nfakkel/DeciZebroPowerSystemControl/README.md

# DeciZebroPowerSystemControl
This repository contains the microcontroller firmware code, the data analysis code and schematics. All are discussed in the Bachelor Thesis: Development of Power System Control for the DeciZebro
