nfakkel/DeciZebroPowerSystemControl/Firmware/Firmware_overview_bms.xlsx

Sheet: SMBUS_ADDRESSES
List of register adresses of sensors |  |  |  | ! in datasheet conf 01h en temp 00h??
 |  | i2c address | Registername | Address | Bits | Description
LM75BD | input: | 1001000 | Conf | 00h | B[4:3] OS_F_QUE[1:0] | Set aantal keer dat Overtemp gemeten moet worden voor alert af gaat
https://www.nxp.com/docs/en/data-sheet/LM75B.pdf | output: | 1001001 |  |  |  | 0 | 1x
 |  |  |  |  |  | 1 | 2x
 |  |  |  |  |  | 2 | 4x
 |  |  |  |  |  | 3 | 6x
 |  |  |  |  | B2 | OS polarity default = 0 we willen active high dus 1
 |  |  |  |  | B1 | OS operation mode default = 0
 |  |  |  |  | B0 | shutdown = 1
 |  |  | Temp | 01h | temperature 2 bytes | two's complement 11 bits 0.125C resolution
 |  |  |  |  | D10 = 0 -> positive temp
 |  |  |  |  | D9 - D0 x 0.125C = temp
 |  |  | Tos | 03h | overtemp shutdown 2 bytes (default 80C)
 |  |  |  |  | D8 - D0 | 0.5C resolution | D8 MSB
 |  |  | Thyst | 05h | D8-D0 | leuk idk
INA226 | PV: | 1000010 | Configuration | 00h
http://www.ti.com/lit/ds/symlink/ina226.pdf | Bus: | 1000000 | Shunt | 01h
 | 5V: | 1000001 | Bus voltage | 02h
 | 3.3V: | 1000011 | power | 03h
 |  |  | Current | 04h
 |  |  | Calibration | 05h
AD5121 |  | 010 1111 | RDAC | ??? | d6-d0?? | Rpot = D/128 * Rab + Rw
http://www.analog.com/media/en/technical-documentation/data-sheets/AD5121_5141.pdf
P9921-R |  | 1100001 | p25-29
https://nl.mouser.com/datasheet/2/464/IDT_P9221-R-Datasheet_DST_20171010-1093280.pdf

Sheet: VIRTUAL_REGISTER_DEFENITIONS
Address |  | Direction | Name | Description | Initial value
Dec | Hex | r
0 | 0x00 | r | ZebroBus version | Highest of the ZebroBus protocol supported
1 | 0x01 | r | class id | Class this module is part of
2 | 0x02 | r | product id | Product ID of this module
3 | 0x03 | r | product version | Product version of this module
4 | 0x04 | r | serial id | Serial number of this module
5 | 0x05 | r | software version | Software version of this module
6 | 0x06 | r | zebrobus address | Primary ZebroBus slave address of this module
7 | 0x07 | r | reserved | Reserved for future use
… | … | r | reserved | Reserved for future use
16 | 0x0F | r | reserved | Reserved for future use
17 | 0x10 | r | quick status | One byte module status message
18 | 0x11 | r | sync counter | Time synchronisation counter
19 | 0x12 | r | loop counter | Counts the times we go through the main control loop
20 | 0x13 | r | error counter | Counts the number of errors that occurred
21 | 0x14 | r | last error | Error code of the last error
22 | 0x15 | r | reserved | Reserved for future use
… | … | r | reserved | Reserved for future use
31 | 0x1F | r | reserved | Reserved for future use
32 | 0x20 | r | State Power System | State of the power system(0x00=shutdown, 0x01=charge, 0x02=discharge, 0x04=error)
33 | 0x21 | r | State Solar input | State of the solar cell(0x00=off, 0x01=on, 0x02=too low, 0x03=too high, 0x04=error)
34 | 0x22 | r | State QI input | State of the qi input(0x00=off, 0x01=on, 0x02=too low, 0x03=too high, 0x04=error)
35 | 0x23 | r | State Laptop input | State of the laptop charge input(0x00=off, 0x01=on, 0x02=too low, 0x03=too high, 0x04=error)
36 | 0x24 | r | State 3.3V output | State of the 3.3V output(0x00=off, 0x01=on, 0x02=too low, 0x03=too high, 0x04=error)
37 | 0x25 | r | State 5V output | State of the 5V output(0x00=off, 0x01=on, 0x02=too low, 0x03=too high, 0x04=error)
38 | 0x26 | r | State 16V output | State of the 16V output(0x00=off, 0x01=on, 0x02=too low, 0x03=too high, 0x04=error)
 |  |  | soc | State of charge of the batteries
 |  |  | soh | State of health of the batteries
 |  |  | battery voltage | Voltage across the battery array [V]
 |  |  | capacity | Capacity of the batteries [mAh]
 |  |  | maximum cell voltage | Maximum voltage across a single battery cell [V]
 |  |  | cell count | Number of cells in battery
 |  |  | maximum current | Maximum current that the batteries can deliver [A]
39 | 27 | r | reserved | Reserved for future use
... | ... | r | reserved | Reserved for future use
64 | 3F | r | reserved | Reserved for future use
