nfakkel/DeciZebroPowerSystemControl/Schematics/BOM/ExcelSheetBOM.xls

Sheet: LM5177
Part | Manufacturer | Part Number | Quantity | Price | Attribute 1 Name | Attribute 1 Value | Attribute 2 Name | Attribute 2 Value | Attribute 3 Name | Attribute 3 Value | Footprint
Cboot1 | Kemet | C0603C104Z3VACTU | 1 | 0.01 | Cap | 100nF | ESR | 1mOhm | Total Derated Cap | 1.0E-7F | 603
Cboot2 | Kemet | C0603C104Z3VACTU | 1 | 0.01 | Cap | 100nF | ESR | 1mOhm | Total Derated Cap | 1.0E-7F | 603
Cbulk | Nichicon | UUD1E680MCL1GS | 1 | 0.12 | Cap | 68uF | ESR | 0.44Ohm | Total Derated Cap | 6.8E-5F | SM_RADIAL_6.3AMM
Ccomp | TDK | C2012C0G1H153J085AA | 1 | 0.07 | Cap | 15nF | ESR | 0Ohm | Total Derated Cap | 1.5E-8F | 805
Ccomp2 | Samsung Electro-Mechanics | CL21C910JBANNNC | 1 | 0.01 | Cap | 91pF | ESR | 0Ohm | Total Derated Cap | 9.1E-11F | 805
Ccs | AVX | 06035A470JAT2A | 1 | 0.01 | Cap | 47pF | ESR | 0.174Ohm | Total Derated Cap | 4.7E-11F | 603
Cf | TDK | C1608X5R1H104K080AA | 1 | 0.01 | Cap | 100nF | ESR | 0.03Ohm | Total Derated Cap | 1.0E-7F | 603
Cin | MuRata | GRM32DR61E106KA12L | 3 | 0.15 | Cap | 10uF | ESR | 2.237mOhm | Total Derated Cap | 1.7E-5F | 1210_280
Cout | Panasonic | 20SVP150M | 1 | 0.76 | Cap | 150uF | ESR | 0.02Ohm | Total Derated Cap | 1.5E-4F | SM_RADIAL_10AMM
Coutx | TDK | C2012X5R1V226M125AC | 1 | 0.38 | Cap | 22uF | ESR | 2.05mOhm | Total Derated Cap | 1.2E-5F | 805
Coutx2 | TDK | C2012X5R1V226M125AC | 1 | 0.38 | Cap | 22uF | ESR | 2.05mOhm | Total Derated Cap | 1.2E-5F | 805
Coutx3 | TDK | C2012X5R1V226M125AC | 1 | 0.38 | Cap | 22uF | ESR | 2.05mOhm | Total Derated Cap | 1.2E-5F | 805
Cslope | Samsung Electro-Mechanics | CL10C111JB8NNNC | 1 | 0.01 | Cap | 110pF | ESR | 0Ohm | Total Derated Cap | 1.1E-10F | 603
Css | Kemet | C0603C153J3GACTU | 1 | 0.09 | Cap | 15nF | ESR | 0Ohm | Total Derated Cap | 1.5E-8F | 603
Cvcc | MuRata | GRM188R61C105KA93D | 1 | 0.02 | Cap | 1uF | ESR | 0.01Ohm | Total Derated Cap | 1.0E-6F | 603
Dboot1 | Nexperia | PMEG6010CEH,115 | 1 | 0.0422 | VFatIo | 0.57V | Io | 1A | VRRM | 60V | SOD-123F
Dboot2 | Nexperia | PMEG6010CEH,115 | 1 | 0.0422 | VFatIo | 0.57V | Io | 1A | VRRM | 60V | SOD-123F
Df | Fairchild Semiconductor | SS14FL | 1 | 0.06 | VFatIo | 0.55V | Io | 1A | VRRM | 40V | SOD-123F
L1 | Coilcraft | XAL7070-222MEB | 1 | 1.19 | L | 2.2uH | DCR | 5.7mOhm | IDC | 17.8A | XAL7070
M1 | Texas Instruments | CSD17310Q5A | 1 | 0.31 | VdsMax | 30V | IdsMax | 100A | Rdson | 5.9mOhm | TRANS_NexFET_Q5A
M2 | Texas Instruments | CSD18514Q5A | 1 | 0.27 | VdsMax | 40V | IdsMax | 50A | Rdson | 7.9mOhm | TRANS_NexFET_Q5A
M3 | Texas Instruments | CSD16321Q5 | 1 | 0.61 | VdsMax | 25V | IdsMax | 100A | Rdson | 2.6mOhm | TRANS_NexFET_Q5
M4 | Texas Instruments | CSD18511Q5A | 1 | 0.44 | VdsMax | 40V | IdsMax | 100A | Rdson | 3.5mOhm | TRANS_NexFET_Q5A
Rcomp | Vishay-Dale | CRCW040210K2FKED | 1 | 0.01 | Resistance | 10.2kOhm | Tolerance | 1% | Power | 0.063W | 402
Rcsg | Vishay-Dale | CRCW0603100RFKEA | 1 | 0.01 | Resistance | 100Ohm | Tolerance | 1% | Power | 0.1W | 603
Rcsp | Vishay-Dale | CRCW0603100RFKEA | 1 | 0.01 | Resistance | 100Ohm | Tolerance | 1% | Power | 0.1W | 603
Rf | Vishay-Dale | CRCW060310R0FKEA | 1 | 0.01 | Resistance | 10Ohm | Tolerance | 1% | Power | 0.1W | 603
Rfbb | Yageo America | RC0603FR-0720KL | 1 | 0.01 | Resistance | 20kOhm | Tolerance | 1% | Power | 0.1W | 603
Rfbt | Yageo America | RC0603FR-07383KL | 1 | 0.01 | Resistance | 383kOhm | Tolerance | 1% | Power | 0.1W | 603
Rpg | Vishay-Dale | CRCW060310K0FKEA | 1 | 0.01 | Resistance | 10kOhm | Tolerance | 1% | Power | 0.1W | 603
Rsense | Rohm | PMR100HZPFU6L00 | 1 | 0.17 | Resistance | 6mOhm | Tolerance | 1% | Power | 2W | 2512
Rt | Vishay-Dale | CRCW040223K2FKED | 1 | 0.01 | Resistance | 23.2kOhm | Tolerance | 1% | Power | 0.063W | 402
Ruvb | Vishay-Dale | CRCW040229K4FKED | 1 | 0.01 | Resistance | 29.4kOhm | Tolerance | 1% | Power | 0.063W | 402
Ruvt | Vishay-Dale | CRCW0402249KFKED | 1 | 0.01 | Resistance | 249kOhm | Tolerance | 1% | Power | 0.063W | 402
U1 | Texas Instruments | LM5176PWPR | 1 | 3 |  |  |  |  |  |  | PWP0028C_N
Cbias | MuRata | GRM21BR71H104KA01L | 1 | 0.04 | Cap | 100nF | ESR | 1mOhm | Total Derated Cap | 1.0E-7F | 805
Rmode | Vishay-Dale | CRCW060393K1FKEA | 1 | 0.01 | Resistance | 93.1kOhm | Tolerance | 1% | Power | 0.1W | 603

Sheet: Control + BMS
Reference | Value | Footprint | Datasheet
J9 | Conn_02x03_Counter_Clockwise
D3 | LED |  | http://www.produktinfo.conrad.com/datenblaetter/175000-199999/184543-da-01-en-LED_20_5mm_rot_WU_8_53_HD.pdf
R4 | R | Resistors_SMD:R_1206 | https://nl.mouser.com/datasheet/2/427/rcge3-254226.pdf
D4 | LED |  | http://www.produktinfo.conrad.com/datenblaetter/175000-199999/184543-da-01-en-LED_20_5mm_rot_WU_8_53_HD.pdf
R5 | R | Resistors_SMD:R_1206 | https://nl.mouser.com/datasheet/2/427/rcge3-254226.pdf
D2 | LED |  | http://www.produktinfo.conrad.com/datenblaetter/175000-199999/184543-da-01-en-LED_20_5mm_rot_WU_8_53_HD.pdf
R3 | R | Resistors_SMD:R_1206 | https://nl.mouser.com/datasheet/2/427/rcge3-254226.pdf
D6 | LED |  | http://www.produktinfo.conrad.com/datenblaetter/175000-199999/184543-da-01-en-LED_20_5mm_rot_WU_8_53_HD.pdf
R7 | R | Resistors_SMD:R_1206 | https://nl.mouser.com/datasheet/2/427/rcge3-254226.pdf
D7 | LED |  | http://www.produktinfo.conrad.com/datenblaetter/175000-199999/184543-da-01-en-LED_20_5mm_rot_WU_8_53_HD.pdf
R8 | R | Resistors_SMD:R_1206 | https://nl.mouser.com/datasheet/2/427/rcge3-254226.pdf
D5 | LED |  | http://www.produktinfo.conrad.com/datenblaetter/175000-199999/184543-da-01-en-LED_20_5mm_rot_WU_8_53_HD.pdf
R6 | R | Resistors_SMD:R_1206 | https://nl.mouser.com/datasheet/2/427/rcge3-254226.pdf
D8 | LED |  | http://www.produktinfo.conrad.com/datenblaetter/175000-199999/184543-da-01-en-LED_20_5mm_rot_WU_8_53_HD.pdf
R9 | R | Resistors_SMD:R_1206 | https://nl.mouser.com/datasheet/2/427/rcge3-254226.pdf
D1 | LED |  | http://www.produktinfo.conrad.com/datenblaetter/175000-199999/184543-da-01-en-LED_20_5mm_rot_WU_8_53_HD.pdf
R2 | R | Resistors_SMD:R_1206 | https://nl.mouser.com/datasheet/2/427/rcge3-254226.pdf
J6 | Conn_02x03_Counter_Clockwise
R1 | 10k
J3 | Conn_01x02
J1 | Conn_01x02
J2 | Conn_01x03
J12 | Conn_01x02
J11 | BMS_DATA_OUT |  | FWS-02-01-T-S
J5 | Conn_01x05 |  | JST-XH 4s
J4 | Conn_01x02
J10 | BMS_POWER_OUT
J8 | BMS_POWER_IN
J7 | BMS_DATA_IN |  | FWS-02-01-T-S
J13 | Conn_01x04 |  | Molex KK 2045
J14 | Conn_01x04 |  | Molex KK 2045
J15 | Conn_01x04 |  | Molex KK 2045
32KHz1 | Crystal
C3 | 18pF
C4 | 18pF
U4 | P82B96
R20 | 2.7k
R19 | 2.7k
R16 | 10k
R17 | 10k
R18 | 100k
Q1 | Q_NMOS_DGS
L1 | Ferrite_Bead | Resistors_SMD:R_0201 | http://www.farnell.com/datasheets/1740433.pdf
C8 | 10u
SW1 | SW_Push
U3 | ATXMEGA32A4U-MH | VQFN44
U1 | LM75
C1 | 0.1u
R11 | 10k | Resistors_SMD:R_0201 | http://www.farnell.com/datasheets/2549522.pdf
C10 | 0.1u
C11 | 0.1u
C5 | CP1
D9 | D_Schottky
C9 | .1u
U2 | LM75
C2 | 0.1u
R12 | 10k | Resistors_SMD:R_0201 | http://www.farnell.com/datasheets/2549522.pdf
R14 | 10k | Resistors_SMD:R_0201 | http://www.farnell.com/datasheets/2549522.pdf
D11 | D_Zener
D12 | D_Zener
D13 | D_Zener
D14 | D_Zener
R10 | 10k | Resistors_SMD:R_0201 | http://www.farnell.com/datasheets/2549522.pdf
R13 | 10k | Resistors_SMD:R_0201 | http://www.farnell.com/datasheets/2549522.pdf
R15 | 10k | Resistors_SMD:R_0201 | http://www.farnell.com/datasheets/2549522.pdf
C6 | 10u
C7 | .1u
D10 | D_Zener
R21 | 1k | Resistors_SMD:R_1206 | https://nl.mouser.com/datasheet/2/427/rcge3-254226.pdf
R22 | 1k | Resistors_SMD:R_1206 | https://nl.mouser.com/datasheet/2/427/rcge3-254226.pdf
R23 | 1k | Resistors_SMD:R_1206 | https://nl.mouser.com/datasheet/2/427/rcge3-254226.pdf
R24 | 1k | Resistors_SMD:R_1206 | https://nl.mouser.com/datasheet/2/427/rcge3-254226.pdf
R25 | 1k | Resistors_SMD:R_1206 | https://nl.mouser.com/datasheet/2/427/rcge3-254226.pdf
R28 | 10k | Resistors_SMD:R_1206 | https://nl.mouser.com/datasheet/2/427/rcge3-254226.pdf
R31 | 1M | Resistors_SMD:R_1206
R33 | 1M | Resistors_SMD:R_1206 | https://nl.mouser.com/datasheet/2/427/rcge3-254226.pdf
R34 | 1M | Resistors_SMD:R_1206 | https://nl.mouser.com/datasheet/2/427/rcge3-254226.pdf
R32 | 100 | Resistors_SMD:R_1206 | https://nl.mouser.com/datasheet/2/427/rcge3-254226.pdf
Q2 | BSZ105N04NSGATMA1 | TO_SOT_Packages_THT:TO-92_Molded_Narrow | https://www.infineon.com/dgdl/Infineon-BSZ105N04NSG-DS-v02_00-en.pdf?fileId=db3a30431689f4420116c485c67f084e
Q4 | BSZ105N04NSGATMA1 | TO_SOT_Packages_THT:TO-92_Molded_Narrow | https://www.infineon.com/dgdl/Infineon-BSZ105N04NSG-DS-v02_00-en.pdf?fileId=db3a30431689f4420116c485c67f084e
Q3 | NVR1P02T1G | TO_SOT_Packages_THT:TO-220_Vertical | https://docs-emea.rs-online.com/webdocs/12e2/0900766b812e287b.pdf
C16 | 1uF | Capacitors_THT:CP_Radial_D22.0mm_P10.00mm_SnapIn | https://docs-emea.rs-online.com/webdocs/13ec/0900766b813ec20a.pdf
C14 | 1uF | Capacitors_THT:CP_Radial_D22.0mm_P10.00mm_SnapIn | https://docs-emea.rs-online.com/webdocs/13ec/0900766b813ec20a.pdf
C13 | 1uF | Capacitors_THT:CP_Radial_D22.0mm_P10.00mm_SnapIn | https://docs-emea.rs-online.com/webdocs/13ec/0900766b813ec20a.pdf
C12 | 1uF | Capacitors_THT:CP_Radial_D22.0mm_P10.00mm_SnapIn | https://docs-emea.rs-online.com/webdocs/13ec/0900766b813ec20a.pdf
C20 | 1uF | Capacitors_THT:CP_Radial_D22.0mm_P10.00mm_SnapIn | https://docs-emea.rs-online.com/webdocs/13ec/0900766b813ec20a.pdf
C21 | 1uF | Capacitors_THT:CP_Radial_D22.0mm_P10.00mm_SnapIn | https://docs-emea.rs-online.com/webdocs/13ec/0900766b813ec20a.pdf
C22 | 1uF | Capacitors_THT:CP_Radial_D22.0mm_P10.00mm_SnapIn | https://docs-emea.rs-online.com/webdocs/13ec/0900766b813ec20a.pdf
C23 | 1uF | Capacitors_THT:CP_Radial_D22.0mm_P10.00mm_SnapIn | https://docs-emea.rs-online.com/webdocs/13ec/0900766b813ec20a.pdf
MMDL301T1G1 | D |  | https://www.onsemi.com/pub/Collateral/MMDL301T1-D.PDF
D_zener1 | ds18010 |  | https://www.diodes.com/assets/Datasheets/ds18010.pdf
R29 | 10k Thermistor |  | https://nl.mouser.com/datasheet/2/362/semitec_atthermistor-1202913.pdf
X1 | bq78350-R1 |  | http://www.ti.com/lit/ds/symlink/bq78350-r1.pdf
R36 | R | Resistors_SMD:R_1206 | https://nl.mouser.com/datasheet/2/427/rcge3-254226.pdf
R37 | R | Resistors_SMD:R_1206 | https://nl.mouser.com/datasheet/2/427/rcge3-254226.pdf
R38 | R | Resistors_SMD:R_1206 | https://nl.mouser.com/datasheet/2/427/rcge3-254226.pdf
R39 | R | Resistors_SMD:R_1206 | https://nl.mouser.com/datasheet/2/427/rcge3-254226.pdf
Q5 | Q_PJFET_SDG
Q6 | Q_NJFET_SDG
R40 | 100k | Resistors_SMD:R_1206 | https://nl.mouser.com/datasheet/2/427/rcge3-254226.pdf
C24 | 0.1uF | Capacitors_THT:CP_Radial_D22.0mm_P10.00mm_SnapIn | https://docs-emea.rs-online.com/webdocs/13ec/0900766b813ec20a.pdf
D15 | LED |  | http://www.produktinfo.conrad.com/datenblaetter/175000-199999/184543-da-01-en-LED_20_5mm_rot_WU_8_53_HD.pdf
D16 | LED |  | http://www.produktinfo.conrad.com/datenblaetter/175000-199999/184543-da-01-en-LED_20_5mm_rot_WU_8_53_HD.pdf
D17 | LED |  | http://www.produktinfo.conrad.com/datenblaetter/175000-199999/184543-da-01-en-LED_20_5mm_rot_WU_8_53_HD.pdf
D18 | LED |  | http://www.produktinfo.conrad.com/datenblaetter/175000-199999/184543-da-01-en-LED_20_5mm_rot_WU_8_53_HD.pdf
D19 | LED |  | http://www.produktinfo.conrad.com/datenblaetter/175000-199999/184543-da-01-en-LED_20_5mm_rot_WU_8_53_HD.pdf
R35 | 221k | Resistors_SMD:R_1206 | http://www.produktinfo.conrad.com/datenblaetter/1200000-1299999/001220484-da-01-en-METALLS__WID__0_6W_221K_5000ST.pdf
U5 | bq76920 |  | http://www.ti.com/lit/ds/symlink/bq76920.pdf
C15 | 1uF | Capacitors_THT:CP_Radial_D22.0mm_P10.00mm_SnapIn | https://docs-emea.rs-online.com/webdocs/13ec/0900766b813ec20a.pdf
R30 | 1M
C19 | 0.1uF | Capacitors_THT:CP_Radial_D22.0mm_P10.00mm_SnapIn | https://docs-emea.rs-online.com/webdocs/13ec/0900766b813ec20a.pdf
C17 | 0.1uF | Capacitors_THT:CP_Radial_D22.0mm_P10.00mm_SnapIn | https://docs-emea.rs-online.com/webdocs/13ec/0900766b813ec20a.pdf
C18 | 0.1uF | Capacitors_THT:CP_Radial_D22.0mm_P10.00mm_SnapIn | https://docs-emea.rs-online.com/webdocs/13ec/0900766b813ec20a.pdf
PE2512FKE7W0R01Z1 | 10m | Resistors_SMD:R_1206 | https://nl.mouser.com/datasheet/2/447/PYu-PE_521_RoHS_L_5-1077989.pdf
R27 | 100 | Resistors_SMD:R_1206 | https://nl.mouser.com/datasheet/2/427/rcge3-254226.pdf
R26 | 100 | Resistors_SMD:R_1206 | https://nl.mouser.com/datasheet/2/427/rcge3-254226.pdf
C25 | 0.1uF | Capacitors_THT:CP_Radial_D22.0mm_P10.00mm_SnapIn | https://docs-emea.rs-online.com/webdocs/13ec/0900766b813ec20a.pdf
R50 | 10
R56 | 10
F5 | Polyfuse
R61 | 150k
R62 | 51k
R59 | 100k
R60 | 100k
F1 | Polyfuse
R57 | 100k
R58 | 100k
R53 | 1.5m
C38 | 1u
INA1 | INA226
R48 | 1k
R54 | 1k
R44 | 10k
R46 | 10k
F2 | Polyfuse
R51 | 5m R_Shunt
C36 | C
F3 | Polyfuse
INA2 | INA226
R49 | 1k
R55 | 1k
R45 | 10k
R47 | 10k
F4 | Polyfuse
R52 | 5m R_Shunt
C37 | C
Css1 | 15nF
Rt1 | 23.2k
Rmode1 | 93.1k
Cin1 | 10uF
M1 | CSD17310Q5A | TO_SOT_Packages_THT:TO-92_Molded_Narrow
M2 | CSD18514Q5A | TO_SOT_Packages_THT:TO-92_Molded_Narrow
M3 | CSD16321Q5 | TO_SOT_Packages_THT:TO-92_Molded_Narrow
M4 | CSD18511Q5A | TO_SOT_Packages_THT:TO-92_Molded_Narrow
Cboot1 | 100nF
Dboot1 | Zener
L3 | 2.20uH
Ccs1 | 47pF
Rcsp1 | 100
Rcsg1 | 100
Rsense1 | 6m
Cboot2 | 100nF
Dboot2 | Zener
Cslope1 | 110pF
Ccomp1 | 91pF
Ccomp2 | 15nF
Rcomp1 | 10.2k
Rfbt1 | 383k
Rfbb1 | 20k
U7 | LM5176 | Housings_SSOP:HTSSOP-28_4.4x9.7mm_Pitch0.65mm_ThermalPad | http://www.ti.com/lit/ds/symlink/lm5176.pdf
Coutx1 | 22uF
Coutx2 | 22uF
Coutx3 | 22uF
Cvcc1 | 1uF
Rpg1 | 10k
Cbulk1 | 68uF
Df1 | Zener
Rf1 | 10
Cf1 | 100nF
Cout1 | CP1
LDO2 | LP38692-3V3 | TO_SOT_Packages_SMD:SOT-223-6 | http://www.ti.com/lit/ds/symlink/lp38692.pdf
LDO1 | LP38692-5V | TO_SOT_Packages_SMD:SOT-223-6 | http://www.ti.com/lit/ds/symlink/lp38692.pdf
C33 | 1uF | Capacitors_THT:CP_Radial_D22.0mm_P10.00mm_SnapIn | https://docs-emea.rs-online.com/webdocs/13ec/0900766b813ec20a.pdf
C32 | 1uF | Capacitors_THT:CP_Radial_D22.0mm_P10.00mm_SnapIn | https://docs-emea.rs-online.com/webdocs/13ec/0900766b813ec20a.pdf
C34 | 1uF | Capacitors_THT:CP_Radial_D22.0mm_P10.00mm_SnapIn | https://docs-emea.rs-online.com/webdocs/13ec/0900766b813ec20a.pdf
C35 | 1uF | Capacitors_THT:CP_Radial_D22.0mm_P10.00mm_SnapIn | https://docs-emea.rs-online.com/webdocs/13ec/0900766b813ec20a.pdf
L2 | 3.3uH
R43 | 75k | Resistors_SMD:R_1206 | https://nl.mouser.com/datasheet/2/427/rcge3-254226.pdf
R41 | 10k | Resistors_SMD:R_1206 | https://nl.mouser.com/datasheet/2/447/PYu-RC_Group_51_RoHS_L_9-1314892.pdf
R42 | 10k | Resistors_SMD:R_1206 | https://nl.mouser.com/datasheet/2/447/PYu-RC_Group_51_RoHS_L_9-1314892.pdf
C30 | 0.1uF | Capacitors_THT:CP_Radial_D22.0mm_P10.00mm_SnapIn | https://docs-emea.rs-online.com/webdocs/13ec/0900766b813ec20a.pdf
C28 | 10uF | Capacitors_THT:CP_Radial_D22.0mm_P10.00mm_SnapIn | https://docs-emea.rs-online.com/webdocs/13ec/0900766b813ec20a.pdf
C26 | 22uF | Capacitors_THT:CP_Radial_D22.0mm_P10.00mm_SnapIn | https://docs-emea.rs-online.com/webdocs/13ec/0900766b813ec20a.pdf
C27 | 22uF | Capacitors_THT:CP_Radial_D22.0mm_P10.00mm_SnapIn | https://docs-emea.rs-online.com/webdocs/13ec/0900766b813ec20a.pdf
C31 | 0.1uF | Capacitors_THT:CP_Radial_D22.0mm_P10.00mm_SnapIn | https://docs-emea.rs-online.com/webdocs/13ec/0900766b813ec20a.pdf
C29 | 10uF | Capacitors_THT:CP_Radial_D22.0mm_P10.00mm_SnapIn | https://docs-emea.rs-online.com/webdocs/13ec/0900766b813ec20a.pdf
U6 | TPS565201 | TO_SOT_Packages_SMD:SOT-23-6 | http://www.ti.com/lit/ds/symlink/tps565201.pdf
U8 | INA300 |  | http://www.ti.com/lit/ds/symlink/ina300-q1.pdf
U9 | LTC4412 | TO_SOT_Packages_SMD:TSOT-23-6 | http://www.analog.com/media/en/technical-documentation/data-sheets/4412fb.pdf
Q8 | IPD85P04P4-07 | TO_SOT_Packages_SMD:TO-252-3_TabPin2 | https://nl.mouser.com/datasheet/2/196/IPD85P04P4-07_DS_10-349929.pdf
R66 | 470k | Resistors_SMD:R_0805_HandSoldering
Q7 | IPD85P04P4-07 | TO_SOT_Packages_SMD:TO-252-3_TabPin2 | https://nl.mouser.com/datasheet/2/196/IPD85P04P4-07_DS_10-349929.pdf
U11 | LT1370 | Power_Integrations:TO-220-7C | http://www.analog.com/media/en/technical-documentation/data-sheets/1370fs.pdf
C43 | 470u | Capacitors_SMD:C_0805_HandSoldering
C47 | 4.7n | Capacitors_SMD:C_0805_HandSoldering
C44 | 4.7n | Capacitors_SMD:C_0805_HandSoldering
R67 | 2k | Resistors_SMD:R_0805_HandSoldering
L4 | 22u | Inductors_SMD:L_1806_Handsoldering
C48 | 47u | Capacitors_SMD:C_0805_HandSoldering
D20 | PMEG100V060ELPDZ | footprints:CFP15 | https://assets.nexperia.com/documents/data-sheet/PMEG100V060ELPD.pdf
L6 | 22u | Inductors_SMD:L_1806_Handsoldering
R70 | 60k | Resistors_SMD:R_0805_HandSoldering
R65 | 11k | Resistors_SMD:R_0805_HandSoldering
C51 | 470u | Capacitors_SMD:CP_Elec_8x10
L5 | 22u | Inductors_SMD:L_1806_Handsoldering
C49 | 47u | Capacitors_SMD:C_0805_HandSoldering
L7 | 22u | Inductors_SMD:L_1806_Handsoldering
Q9 | BSS316N H6327 | TO_SOT_Packages_SMD:SOT-23 | https://nl.mouser.com/datasheet/2/196/BSS316N_Rev2.3-63035.pdf
D21 | MBR360G | Diodes_THT:D_DO-201_P15.24mm_Horizontal | https://www.onsemi.com/pub/Collateral/MBR350-D.PDF
C50 | 470u | Capacitors_SMD:CP_Elec_8x10
U10 | AD5121 | Universal:LFCSP 20 | https://nl.mouser.com/datasheet/2/609/AD5121_5141-877035.pdf
C41 | 0.1u | Capacitors_SMD:C_0805_HandSoldering
C45 | 10u | Capacitors_SMD:C_0805_HandSoldering
C42 | 0.1u | Capacitors_SMD:C_0805_HandSoldering
C46 | 10u | Capacitors_SMD:C_0805_HandSoldering
C39 | 0.1u | Capacitors_SMD:C_0805_HandSoldering
C40 | 10u | Capacitors_SMD:C_0805_HandSoldering
R68 | 12k | Resistors_SMD:R_0805_HandSoldering
R69 | 10k | Resistors_SMD:R_0805_HandSoldering
R63 | 63k | Resistors_SMD:R_0805_HandSoldering
R64 | 10k | Resistors_SMD:R_0805_HandSoldering
Q10 | IPD85P04P4-07 | TO_SOT_Packages_SMD:TO-252-3_TabPin2 | https://nl.mouser.com/datasheet/2/196/IPD85P04P4-07_DS_10-349929.pdf
Q11 | IPD85P04P4-07 | TO_SOT_Packages_SMD:TO-252-3_TabPin2 | https://nl.mouser.com/datasheet/2/196/IPD85P04P4-07_DS_10-349929.pdf
U12 | LM3480-3.3 | TO_SOT_Packages_SMD:SOT-23 | http://www.ti.com/lit/ds/symlink/lm3480.pdf
C53 | 1u
C52 | 1u
C58 | 15n | Capacitors_SMD:C_0805_HandSoldering
C59 | 15n | Capacitors_SMD:C_0805_HandSoldering
C56 | 47n | Capacitors_SMD:C_0805_HandSoldering
C57 | 47n | Capacitors_SMD:C_0805_HandSoldering
R72 | 10k | Resistors_SMD:R_1218_HandSoldering
R73 | 10k | Resistors_SMD:R_1218_HandSoldering
R74 | 10k | Resistors_SMD:R_1218_HandSoldering
C61 | 10u | Capacitors_SMD:C_0805_HandSoldering
C63 | 10u | Capacitors_SMD:C_0805_HandSoldering
C65 | 10u | Capacitors_SMD:C_0805_HandSoldering
C67 | 0.1u | Capacitors_SMD:C_0805_HandSoldering
R75 | 36 | Resistors_SMD:R_1218_HandSoldering
C64 | 10u | Capacitors_SMD:C_0805_HandSoldering
C66 | 10u | Capacitors_SMD:C_0805_HandSoldering
C60 | 1u | Capacitors_SMD:C_0805_HandSoldering
C62 | 1u | Capacitors_SMD:C_0805_HandSoldering
R77 | 10k | Resistors_SMD:R_1218_HandSoldering
R80 | 10k | Resistors_SMD:R_1218_HandSoldering
R76 | 10k | Resistors_SMD:R_1218_HandSoldering
R79 | 5.1k | Resistors_SMD:R_1218_HandSoldering
R78 | 5.1k | Resistors_SMD:R_1218_HandSoldering
R71 | 10k | Resistors_SMD:R_1218_HandSoldering
C55 | 1.7n | Capacitors_SMD:C_0805_HandSoldering
C54 | 160u | Capacitors_SMD:C_0805_HandSoldering
U13 | P9221R | WLCSP-52:WLCSP-52_2.64x3.94mm_Pitch0.4mm | https://nl.mouser.com/datasheet/2/464/IDT_P9221-R-Datasheet_DST_20171010-1093280.pdf

Sheet: Input
Reference | Value | Footprint | Datasheet
U1 | LTC4412 | TO_SOT_Packages_SMD:TSOT-23-6 | http://www.analog.com/media/en/technical-documentation/data-sheets/4412fb.pdf
Q2 | IPD85P04P4-07 | TO_SOT_Packages_SMD:TO-252-3_TabPin2 | https://nl.mouser.com/datasheet/2/196/IPD85P04P4-07_DS_10-349929.pdf
R1 | 470k | Resistors_SMD:R_0805_HandSoldering
Q1 | IPD85P04P4-07 | TO_SOT_Packages_SMD:TO-252-3_TabPin2 | https://nl.mouser.com/datasheet/2/196/IPD85P04P4-07_DS_10-349929.pdf
U2 | LT1370 | Power_Integrations:TO-220-7C | http://www.analog.com/media/en/technical-documentation/data-sheets/1370fs.pdf
C1 | 470u | Capacitors_SMD:C_0805_HandSoldering
C3 | 4.7n | Capacitors_SMD:C_0805_HandSoldering
C2 | 4.7n | Capacitors_SMD:C_0805_HandSoldering
R2 | 2k | Resistors_SMD:R_0805_HandSoldering
L1 | 22u | Inductors_SMD:L_1806_Handsoldering
C4 | 47u | Capacitors_SMD:C_0805_HandSoldering
D1 | PMEG100V060ELPDZ | footprints:CFP15 | https://assets.nexperia.com/documents/data-sheet/PMEG100V060ELPD.pdf
L2 | 22u | Inductors_SMD:L_1806_Handsoldering
R3 | 60k | Resistors_SMD:R_0805_HandSoldering
R4 | 11k | Resistors_SMD:R_0805_HandSoldering
C5 | 470u | Capacitors_SMD:CP_Elec_8x10
L3 | 22u | Inductors_SMD:L_1806_Handsoldering
C12 | 47u | Capacitors_SMD:C_0805_HandSoldering
L4 | 22u | Inductors_SMD:L_1806_Handsoldering
Q3 | BSS316N H6327 | TO_SOT_Packages_SMD:SOT-23 | https://nl.mouser.com/datasheet/2/196/BSS316N_Rev2.3-63035.pdf
D2 | MBR360G | Diodes_THT:D_DO-201_P15.24mm_Horizontal | https://www.onsemi.com/pub/Collateral/MBR350-D.PDF
C13 | 470u | Capacitors_SMD:CP_Elec_8x10
U3 | AD5121 | Universal:LFCSP 20 | https://nl.mouser.com/datasheet/2/609/AD5121_5141-877035.pdf
C8 | 0.1u | Capacitors_SMD:C_0805_HandSoldering
C9 | 10u | Capacitors_SMD:C_0805_HandSoldering
C10 | 0.1u | Capacitors_SMD:C_0805_HandSoldering
C11 | 10u | Capacitors_SMD:C_0805_HandSoldering
C6 | 0.1u | Capacitors_SMD:C_0805_HandSoldering
C7 | 10u | Capacitors_SMD:C_0805_HandSoldering
R5 | 12k | Resistors_SMD:R_0805_HandSoldering
R6 | 10k | Resistors_SMD:R_0805_HandSoldering
R7 | 63k | Resistors_SMD:R_0805_HandSoldering
R8 | 10k | Resistors_SMD:R_0805_HandSoldering
Q4 | IPD85P04P4-07 | TO_SOT_Packages_SMD:TO-252-3_TabPin2 | https://nl.mouser.com/datasheet/2/196/IPD85P04P4-07_DS_10-349929.pdf
Q5 | IPD85P04P4-07 | TO_SOT_Packages_SMD:TO-252-3_TabPin2 | https://nl.mouser.com/datasheet/2/196/IPD85P04P4-07_DS_10-349929.pdf

Sheet: Output
Reference | Value | Footprint | Datasheet
J9 | Conn_02x03_Counter_Clockwise
D3 | LED |  | http://www.produktinfo.conrad.com/datenblaetter/175000-199999/184543-da-01-en-LED_20_5mm_rot_WU_8_53_HD.pdf
R4 | R | Resistors_SMD:R_1206 | https://nl.mouser.com/datasheet/2/427/rcge3-254226.pdf
D4 | LED |  | http://www.produktinfo.conrad.com/datenblaetter/175000-199999/184543-da-01-en-LED_20_5mm_rot_WU_8_53_HD.pdf
R5 | R | Resistors_SMD:R_1206 | https://nl.mouser.com/datasheet/2/427/rcge3-254226.pdf
D2 | LED |  | http://www.produktinfo.conrad.com/datenblaetter/175000-199999/184543-da-01-en-LED_20_5mm_rot_WU_8_53_HD.pdf
R3 | R | Resistors_SMD:R_1206 | https://nl.mouser.com/datasheet/2/427/rcge3-254226.pdf
D6 | LED |  | http://www.produktinfo.conrad.com/datenblaetter/175000-199999/184543-da-01-en-LED_20_5mm_rot_WU_8_53_HD.pdf
R7 | R | Resistors_SMD:R_1206 | https://nl.mouser.com/datasheet/2/427/rcge3-254226.pdf
D7 | LED |  | http://www.produktinfo.conrad.com/datenblaetter/175000-199999/184543-da-01-en-LED_20_5mm_rot_WU_8_53_HD.pdf
R8 | R | Resistors_SMD:R_1206 | https://nl.mouser.com/datasheet/2/427/rcge3-254226.pdf
D5 | LED |  | http://www.produktinfo.conrad.com/datenblaetter/175000-199999/184543-da-01-en-LED_20_5mm_rot_WU_8_53_HD.pdf
R6 | R | Resistors_SMD:R_1206 | https://nl.mouser.com/datasheet/2/427/rcge3-254226.pdf
D8 | LED |  | http://www.produktinfo.conrad.com/datenblaetter/175000-199999/184543-da-01-en-LED_20_5mm_rot_WU_8_53_HD.pdf
R9 | R | Resistors_SMD:R_1206 | https://nl.mouser.com/datasheet/2/427/rcge3-254226.pdf
D1 | LED |  | http://www.produktinfo.conrad.com/datenblaetter/175000-199999/184543-da-01-en-LED_20_5mm_rot_WU_8_53_HD.pdf
R2 | R | Resistors_SMD:R_1206 | https://nl.mouser.com/datasheet/2/427/rcge3-254226.pdf
J6 | Conn_02x03_Counter_Clockwise
R1 | 10k
J3 | Conn_01x02
J1 | Conn_01x02
J2 | Conn_01x03
J12 | Conn_01x02
J11 | BMS_DATA_OUT |  | FWS-02-01-T-S
J5 | Conn_01x05 |  | JST-XH 4s
J4 | Conn_01x02
J10 | BMS_POWER_OUT
J8 | BMS_POWER_IN
J7 | BMS_DATA_IN |  | FWS-02-01-T-S
J13 | Conn_01x04 |  | Molex KK 2045
J14 | Conn_01x04 |  | Molex KK 2045
J15 | Conn_01x04 |  | Molex KK 2045
32KHz1 | Crystal
C3 | 18pF
C4 | 18pF
U4 | P82B96
R20 | 2.7k
R19 | 2.7k
R16 | 10k
R17 | 10k
R18 | 100k
Q1 | Q_NMOS_DGS
L1 | Ferrite_Bead | Resistors_SMD:R_0201 | http://www.farnell.com/datasheets/1740433.pdf
C8 | 10u
SW1 | SW_Push
U3 | ATXMEGA32A4U-MH | VQFN44
U1 | LM75
C1 | 0.1u
R11 | 10k | Resistors_SMD:R_0201 | http://www.farnell.com/datasheets/2549522.pdf
C10 | 0.1u
C11 | 0.1u
C5 | CP1
D9 | D_Schottky
C9 | .1u
U2 | LM75
C2 | 0.1u
R12 | 10k | Resistors_SMD:R_0201 | http://www.farnell.com/datasheets/2549522.pdf
R14 | 10k | Resistors_SMD:R_0201 | http://www.farnell.com/datasheets/2549522.pdf
D11 | D_Zener
D12 | D_Zener
D13 | D_Zener
D14 | D_Zener
R10 | 10k | Resistors_SMD:R_0201 | http://www.farnell.com/datasheets/2549522.pdf
R13 | 10k | Resistors_SMD:R_0201 | http://www.farnell.com/datasheets/2549522.pdf
R15 | 10k | Resistors_SMD:R_0201 | http://www.farnell.com/datasheets/2549522.pdf
C6 | 10u
C7 | .1u
D10 | D_Zener
R21 | 1k | Resistors_SMD:R_1206 | https://nl.mouser.com/datasheet/2/427/rcge3-254226.pdf
R22 | 1k | Resistors_SMD:R_1206 | https://nl.mouser.com/datasheet/2/427/rcge3-254226.pdf
R23 | 1k | Resistors_SMD:R_1206 | https://nl.mouser.com/datasheet/2/427/rcge3-254226.pdf
R24 | 1k | Resistors_SMD:R_1206 | https://nl.mouser.com/datasheet/2/427/rcge3-254226.pdf
R25 | 1k | Resistors_SMD:R_1206 | https://nl.mouser.com/datasheet/2/427/rcge3-254226.pdf
R28 | 10k | Resistors_SMD:R_1206 | https://nl.mouser.com/datasheet/2/427/rcge3-254226.pdf
R31 | 1M | Resistors_SMD:R_1206
R33 | 1M | Resistors_SMD:R_1206 | https://nl.mouser.com/datasheet/2/427/rcge3-254226.pdf
R34 | 1M | Resistors_SMD:R_1206 | https://nl.mouser.com/datasheet/2/427/rcge3-254226.pdf
R32 | 100 | Resistors_SMD:R_1206 | https://nl.mouser.com/datasheet/2/427/rcge3-254226.pdf
Q2 | BSZ105N04NSGATMA1 | TO_SOT_Packages_THT:TO-92_Molded_Narrow | https://www.infineon.com/dgdl/Infineon-BSZ105N04NSG-DS-v02_00-en.pdf?fileId=db3a30431689f4420116c485c67f084e
Q4 | BSZ105N04NSGATMA1 | TO_SOT_Packages_THT:TO-92_Molded_Narrow | https://www.infineon.com/dgdl/Infineon-BSZ105N04NSG-DS-v02_00-en.pdf?fileId=db3a30431689f4420116c485c67f084e
Q3 | NVR1P02T1G | TO_SOT_Packages_THT:TO-220_Vertical | https://docs-emea.rs-online.com/webdocs/12e2/0900766b812e287b.pdf
C16 | 1uF | Capacitors_THT:CP_Radial_D22.0mm_P10.00mm_SnapIn | https://docs-emea.rs-online.com/webdocs/13ec/0900766b813ec20a.pdf
C14 | 1uF | Capacitors_THT:CP_Radial_D22.0mm_P10.00mm_SnapIn | https://docs-emea.rs-online.com/webdocs/13ec/0900766b813ec20a.pdf
C13 | 1uF | Capacitors_THT:CP_Radial_D22.0mm_P10.00mm_SnapIn | https://docs-emea.rs-online.com/webdocs/13ec/0900766b813ec20a.pdf
C12 | 1uF | Capacitors_THT:CP_Radial_D22.0mm_P10.00mm_SnapIn | https://docs-emea.rs-online.com/webdocs/13ec/0900766b813ec20a.pdf
C20 | 1uF | Capacitors_THT:CP_Radial_D22.0mm_P10.00mm_SnapIn | https://docs-emea.rs-online.com/webdocs/13ec/0900766b813ec20a.pdf
C21 | 1uF | Capacitors_THT:CP_Radial_D22.0mm_P10.00mm_SnapIn | https://docs-emea.rs-online.com/webdocs/13ec/0900766b813ec20a.pdf
C22 | 1uF | Capacitors_THT:CP_Radial_D22.0mm_P10.00mm_SnapIn | https://docs-emea.rs-online.com/webdocs/13ec/0900766b813ec20a.pdf
C23 | 1uF | Capacitors_THT:CP_Radial_D22.0mm_P10.00mm_SnapIn | https://docs-emea.rs-online.com/webdocs/13ec/0900766b813ec20a.pdf
MMDL301T1G1 | D |  | https://www.onsemi.com/pub/Collateral/MMDL301T1-D.PDF
D_zener1 | ds18010 |  | https://www.diodes.com/assets/Datasheets/ds18010.pdf
R29 | 10k Thermistor |  | https://nl.mouser.com/datasheet/2/362/semitec_atthermistor-1202913.pdf
X1 | bq78350-R1 |  | http://www.ti.com/lit/ds/symlink/bq78350-r1.pdf
R36 | R | Resistors_SMD:R_1206 | https://nl.mouser.com/datasheet/2/427/rcge3-254226.pdf
R37 | R | Resistors_SMD:R_1206 | https://nl.mouser.com/datasheet/2/427/rcge3-254226.pdf
R38 | R | Resistors_SMD:R_1206 | https://nl.mouser.com/datasheet/2/427/rcge3-254226.pdf
R39 | R | Resistors_SMD:R_1206 | https://nl.mouser.com/datasheet/2/427/rcge3-254226.pdf
Q5 | Q_PJFET_SDG
Q6 | Q_NJFET_SDG
R40 | 100k | Resistors_SMD:R_1206 | https://nl.mouser.com/datasheet/2/427/rcge3-254226.pdf
C24 | 0.1uF | Capacitors_THT:CP_Radial_D22.0mm_P10.00mm_SnapIn | https://docs-emea.rs-online.com/webdocs/13ec/0900766b813ec20a.pdf
D15 | LED |  | http://www.produktinfo.conrad.com/datenblaetter/175000-199999/184543-da-01-en-LED_20_5mm_rot_WU_8_53_HD.pdf
D16 | LED |  | http://www.produktinfo.conrad.com/datenblaetter/175000-199999/184543-da-01-en-LED_20_5mm_rot_WU_8_53_HD.pdf
D17 | LED |  | http://www.produktinfo.conrad.com/datenblaetter/175000-199999/184543-da-01-en-LED_20_5mm_rot_WU_8_53_HD.pdf
D18 | LED |  | http://www.produktinfo.conrad.com/datenblaetter/175000-199999/184543-da-01-en-LED_20_5mm_rot_WU_8_53_HD.pdf
D19 | LED |  | http://www.produktinfo.conrad.com/datenblaetter/175000-199999/184543-da-01-en-LED_20_5mm_rot_WU_8_53_HD.pdf
R35 | 221k | Resistors_SMD:R_1206 | http://www.produktinfo.conrad.com/datenblaetter/1200000-1299999/001220484-da-01-en-METALLS__WID__0_6W_221K_5000ST.pdf
U5 | bq76920 |  | http://www.ti.com/lit/ds/symlink/bq76920.pdf
C15 | 1uF | Capacitors_THT:CP_Radial_D22.0mm_P10.00mm_SnapIn | https://docs-emea.rs-online.com/webdocs/13ec/0900766b813ec20a.pdf
R30 | 1M
C19 | 0.1uF | Capacitors_THT:CP_Radial_D22.0mm_P10.00mm_SnapIn | https://docs-emea.rs-online.com/webdocs/13ec/0900766b813ec20a.pdf
C17 | 0.1uF | Capacitors_THT:CP_Radial_D22.0mm_P10.00mm_SnapIn | https://docs-emea.rs-online.com/webdocs/13ec/0900766b813ec20a.pdf
C18 | 0.1uF | Capacitors_THT:CP_Radial_D22.0mm_P10.00mm_SnapIn | https://docs-emea.rs-online.com/webdocs/13ec/0900766b813ec20a.pdf
PE2512FKE7W0R01Z1 | 10m | Resistors_SMD:R_1206 | https://nl.mouser.com/datasheet/2/447/PYu-PE_521_RoHS_L_5-1077989.pdf
R27 | 100 | Resistors_SMD:R_1206 | https://nl.mouser.com/datasheet/2/427/rcge3-254226.pdf
R26 | 100 | Resistors_SMD:R_1206 | https://nl.mouser.com/datasheet/2/427/rcge3-254226.pdf
C25 | 0.1uF | Capacitors_THT:CP_Radial_D22.0mm_P10.00mm_SnapIn | https://docs-emea.rs-online.com/webdocs/13ec/0900766b813ec20a.pdf
R50 | 10
R56 | 10
F5 | Polyfuse
R61 | 150k
R62 | 51k
R59 | 100k
R60 | 100k
F1 | Polyfuse
R57 | 100k
R58 | 100k
R53 | 1.5m
C38 | 1u
INA1 | INA226
R48 | 1k
R54 | 1k
R44 | 10k
R46 | 10k
F2 | Polyfuse
R51 | 5m R_Shunt
C36 | C
F3 | Polyfuse
INA2 | INA226
R49 | 1k
R55 | 1k
R45 | 10k
R47 | 10k
F4 | Polyfuse
R52 | 5m R_Shunt
C37 | C
Css1 | 15nF
Rt1 | 23.2k
Rmode1 | 93.1k
Cin1 | 10uF
M1 | CSD17310Q5A | TO_SOT_Packages_THT:TO-92_Molded_Narrow
M2 | CSD18514Q5A | TO_SOT_Packages_THT:TO-92_Molded_Narrow
M3 | CSD16321Q5 | TO_SOT_Packages_THT:TO-92_Molded_Narrow
M4 | CSD18511Q5A | TO_SOT_Packages_THT:TO-92_Molded_Narrow
Cboot1 | 100nF
Dboot1 | Zener
L3 | 2.20uH
Ccs1 | 47pF
Rcsp1 | 100
Rcsg1 | 100
Rsense1 | 6m
Cboot2 | 100nF
Dboot2 | Zener
Cslope1 | 110pF
Ccomp1 | 91pF
Ccomp2 | 15nF
Rcomp1 | 10.2k
Rfbt1 | 383k
Rfbb1 | 20k
U7 | LM5176 | Housings_SSOP:HTSSOP-28_4.4x9.7mm_Pitch0.65mm_ThermalPad | http://www.ti.com/lit/ds/symlink/lm5176.pdf
Coutx1 | 22uF
Coutx2 | 22uF
Coutx3 | 22uF
Cvcc1 | 1uF
Rpg1 | 10k
Cbulk1 | 68uF
Df1 | Zener
Rf1 | 10
Cf1 | 100nF
Cout1 | CP1
LDO2 | LP38692-3V3 | TO_SOT_Packages_SMD:SOT-223-6 | http://www.ti.com/lit/ds/symlink/lp38692.pdf
LDO1 | LP38692-5V | TO_SOT_Packages_SMD:SOT-223-6 | http://www.ti.com/lit/ds/symlink/lp38692.pdf
C33 | 1uF | Capacitors_THT:CP_Radial_D22.0mm_P10.00mm_SnapIn | https://docs-emea.rs-online.com/webdocs/13ec/0900766b813ec20a.pdf
C32 | 1uF | Capacitors_THT:CP_Radial_D22.0mm_P10.00mm_SnapIn | https://docs-emea.rs-online.com/webdocs/13ec/0900766b813ec20a.pdf
C34 | 1uF | Capacitors_THT:CP_Radial_D22.0mm_P10.00mm_SnapIn | https://docs-emea.rs-online.com/webdocs/13ec/0900766b813ec20a.pdf
C35 | 1uF | Capacitors_THT:CP_Radial_D22.0mm_P10.00mm_SnapIn | https://docs-emea.rs-online.com/webdocs/13ec/0900766b813ec20a.pdf
L2 | 3.3uH
R43 | 75k | Resistors_SMD:R_1206 | https://nl.mouser.com/datasheet/2/427/rcge3-254226.pdf
R41 | 10k | Resistors_SMD:R_1206 | https://nl.mouser.com/datasheet/2/447/PYu-RC_Group_51_RoHS_L_9-1314892.pdf
R42 | 10k | Resistors_SMD:R_1206 | https://nl.mouser.com/datasheet/2/447/PYu-RC_Group_51_RoHS_L_9-1314892.pdf
C30 | 0.1uF | Capacitors_THT:CP_Radial_D22.0mm_P10.00mm_SnapIn | https://docs-emea.rs-online.com/webdocs/13ec/0900766b813ec20a.pdf
C28 | 10uF | Capacitors_THT:CP_Radial_D22.0mm_P10.00mm_SnapIn | https://docs-emea.rs-online.com/webdocs/13ec/0900766b813ec20a.pdf
C26 | 22uF | Capacitors_THT:CP_Radial_D22.0mm_P10.00mm_SnapIn | https://docs-emea.rs-online.com/webdocs/13ec/0900766b813ec20a.pdf
C27 | 22uF | Capacitors_THT:CP_Radial_D22.0mm_P10.00mm_SnapIn | https://docs-emea.rs-online.com/webdocs/13ec/0900766b813ec20a.pdf
C31 | 0.1uF | Capacitors_THT:CP_Radial_D22.0mm_P10.00mm_SnapIn | https://docs-emea.rs-online.com/webdocs/13ec/0900766b813ec20a.pdf
C29 | 10uF | Capacitors_THT:CP_Radial_D22.0mm_P10.00mm_SnapIn | https://docs-emea.rs-online.com/webdocs/13ec/0900766b813ec20a.pdf
U6 | TPS565201 | TO_SOT_Packages_SMD:SOT-23-6 | http://www.ti.com/lit/ds/symlink/tps565201.pdf
U8 | INA300 |  | http://www.ti.com/lit/ds/symlink/ina300-q1.pdf
U9 | LTC4412 | TO_SOT_Packages_SMD:TSOT-23-6 | http://www.analog.com/media/en/technical-documentation/data-sheets/4412fb.pdf
Q8 | IPD85P04P4-07 | TO_SOT_Packages_SMD:TO-252-3_TabPin2 | https://nl.mouser.com/datasheet/2/196/IPD85P04P4-07_DS_10-349929.pdf
R66 | 470k | Resistors_SMD:R_0805_HandSoldering
Q7 | IPD85P04P4-07 | TO_SOT_Packages_SMD:TO-252-3_TabPin2 | https://nl.mouser.com/datasheet/2/196/IPD85P04P4-07_DS_10-349929.pdf
U11 | LT1370 | Power_Integrations:TO-220-7C | http://www.analog.com/media/en/technical-documentation/data-sheets/1370fs.pdf
C43 | 470u | Capacitors_SMD:C_0805_HandSoldering
C47 | 4.7n | Capacitors_SMD:C_0805_HandSoldering
C44 | 4.7n | Capacitors_SMD:C_0805_HandSoldering
R67 | 2k | Resistors_SMD:R_0805_HandSoldering
L4 | 22u | Inductors_SMD:L_1806_Handsoldering
C48 | 47u | Capacitors_SMD:C_0805_HandSoldering
D20 | PMEG100V060ELPDZ | footprints:CFP15 | https://assets.nexperia.com/documents/data-sheet/PMEG100V060ELPD.pdf
L6 | 22u | Inductors_SMD:L_1806_Handsoldering
R70 | 60k | Resistors_SMD:R_0805_HandSoldering
R65 | 11k | Resistors_SMD:R_0805_HandSoldering
C51 | 470u | Capacitors_SMD:CP_Elec_8x10
L5 | 22u | Inductors_SMD:L_1806_Handsoldering
C49 | 47u | Capacitors_SMD:C_0805_HandSoldering
L7 | 22u | Inductors_SMD:L_1806_Handsoldering
Q9 | BSS316N H6327 | TO_SOT_Packages_SMD:SOT-23 | https://nl.mouser.com/datasheet/2/196/BSS316N_Rev2.3-63035.pdf
D21 | MBR360G | Diodes_THT:D_DO-201_P15.24mm_Horizontal | https://www.onsemi.com/pub/Collateral/MBR350-D.PDF
C50 | 470u | Capacitors_SMD:CP_Elec_8x10
U10 | AD5121 | Universal:LFCSP 20 | https://nl.mouser.com/datasheet/2/609/AD5121_5141-877035.pdf
C41 | 0.1u | Capacitors_SMD:C_0805_HandSoldering
C45 | 10u | Capacitors_SMD:C_0805_HandSoldering
C42 | 0.1u | Capacitors_SMD:C_0805_HandSoldering
C46 | 10u | Capacitors_SMD:C_0805_HandSoldering
C39 | 0.1u | Capacitors_SMD:C_0805_HandSoldering
C40 | 10u | Capacitors_SMD:C_0805_HandSoldering
R68 | 12k | Resistors_SMD:R_0805_HandSoldering
R69 | 10k | Resistors_SMD:R_0805_HandSoldering
R63 | 63k | Resistors_SMD:R_0805_HandSoldering
R64 | 10k | Resistors_SMD:R_0805_HandSoldering
Q10 | IPD85P04P4-07 | TO_SOT_Packages_SMD:TO-252-3_TabPin2 | https://nl.mouser.com/datasheet/2/196/IPD85P04P4-07_DS_10-349929.pdf
Q11 | IPD85P04P4-07 | TO_SOT_Packages_SMD:TO-252-3_TabPin2 | https://nl.mouser.com/datasheet/2/196/IPD85P04P4-07_DS_10-349929.pdf
U12 | LM3480-3.3 | TO_SOT_Packages_SMD:SOT-23 | http://www.ti.com/lit/ds/symlink/lm3480.pdf
C53 | 1u
C52 | 1u
C58 | 15n | Capacitors_SMD:C_0805_HandSoldering
C59 | 15n | Capacitors_SMD:C_0805_HandSoldering
C56 | 47n | Capacitors_SMD:C_0805_HandSoldering
C57 | 47n | Capacitors_SMD:C_0805_HandSoldering
R72 | 10k | Resistors_SMD:R_1218_HandSoldering
R73 | 10k | Resistors_SMD:R_1218_HandSoldering
R74 | 10k | Resistors_SMD:R_1218_HandSoldering
C61 | 10u | Capacitors_SMD:C_0805_HandSoldering
C63 | 10u | Capacitors_SMD:C_0805_HandSoldering
C65 | 10u | Capacitors_SMD:C_0805_HandSoldering
C67 | 0.1u | Capacitors_SMD:C_0805_HandSoldering
R75 | 36 | Resistors_SMD:R_1218_HandSoldering
C64 | 10u | Capacitors_SMD:C_0805_HandSoldering
C66 | 10u | Capacitors_SMD:C_0805_HandSoldering
C60 | 1u | Capacitors_SMD:C_0805_HandSoldering
C62 | 1u | Capacitors_SMD:C_0805_HandSoldering
R77 | 10k | Resistors_SMD:R_1218_HandSoldering
R80 | 10k | Resistors_SMD:R_1218_HandSoldering
R76 | 10k | Resistors_SMD:R_1218_HandSoldering
R79 | 5.1k | Resistors_SMD:R_1218_HandSoldering
R78 | 5.1k | Resistors_SMD:R_1218_HandSoldering
R71 | 10k | Resistors_SMD:R_1218_HandSoldering
C55 | 1.7n | Capacitors_SMD:C_0805_HandSoldering
C54 | 160u | Capacitors_SMD:C_0805_HandSoldering
U13 | P9221R | WLCSP-52:WLCSP-52_2.64x3.94mm_Pitch0.4mm | https://nl.mouser.com/datasheet/2/464/IDT_P9221-R-Datasheet_DST_20171010-1093280.pdf

Sheet: Powerbus
Reference | Value | Footprint | Datasheet
J9 | Conn_02x03_Counter_Clockwise
D3 | LED |  | http://www.produktinfo.conrad.com/datenblaetter/175000-199999/184543-da-01-en-LED_20_5mm_rot_WU_8_53_HD.pdf
R4 | R | Resistors_SMD:R_1206 | https://nl.mouser.com/datasheet/2/427/rcge3-254226.pdf
D4 | LED |  | http://www.produktinfo.conrad.com/datenblaetter/175000-199999/184543-da-01-en-LED_20_5mm_rot_WU_8_53_HD.pdf
R5 | R | Resistors_SMD:R_1206 | https://nl.mouser.com/datasheet/2/427/rcge3-254226.pdf
D2 | LED |  | http://www.produktinfo.conrad.com/datenblaetter/175000-199999/184543-da-01-en-LED_20_5mm_rot_WU_8_53_HD.pdf
R3 | R | Resistors_SMD:R_1206 | https://nl.mouser.com/datasheet/2/427/rcge3-254226.pdf
D6 | LED |  | http://www.produktinfo.conrad.com/datenblaetter/175000-199999/184543-da-01-en-LED_20_5mm_rot_WU_8_53_HD.pdf
R7 | R | Resistors_SMD:R_1206 | https://nl.mouser.com/datasheet/2/427/rcge3-254226.pdf
D7 | LED |  | http://www.produktinfo.conrad.com/datenblaetter/175000-199999/184543-da-01-en-LED_20_5mm_rot_WU_8_53_HD.pdf
R8 | R | Resistors_SMD:R_1206 | https://nl.mouser.com/datasheet/2/427/rcge3-254226.pdf
D5 | LED |  | http://www.produktinfo.conrad.com/datenblaetter/175000-199999/184543-da-01-en-LED_20_5mm_rot_WU_8_53_HD.pdf
R6 | R | Resistors_SMD:R_1206 | https://nl.mouser.com/datasheet/2/427/rcge3-254226.pdf
D8 | LED |  | http://www.produktinfo.conrad.com/datenblaetter/175000-199999/184543-da-01-en-LED_20_5mm_rot_WU_8_53_HD.pdf
R9 | R | Resistors_SMD:R_1206 | https://nl.mouser.com/datasheet/2/427/rcge3-254226.pdf
D1 | LED |  | http://www.produktinfo.conrad.com/datenblaetter/175000-199999/184543-da-01-en-LED_20_5mm_rot_WU_8_53_HD.pdf
R2 | R | Resistors_SMD:R_1206 | https://nl.mouser.com/datasheet/2/427/rcge3-254226.pdf
J6 | Conn_02x03_Counter_Clockwise
R1 | 10k
J3 | Conn_01x02
J1 | Conn_01x02
J2 | Conn_01x03
J12 | Conn_01x02
J11 | BMS_DATA_OUT |  | FWS-02-01-T-S
J5 | Conn_01x05 |  | JST-XH 4s
J4 | Conn_01x02
J10 | BMS_POWER_OUT
J8 | BMS_POWER_IN
J7 | BMS_DATA_IN |  | FWS-02-01-T-S
J13 | Conn_01x04 |  | Molex KK 2045
J14 | Conn_01x04 |  | Molex KK 2045
J15 | Conn_01x04 |  | Molex KK 2045
32KHz1 | Crystal
C3 | 18pF
C4 | 18pF
U4 | P82B96
R20 | 2.7k
R19 | 2.7k
R16 | 10k
R17 | 10k
R18 | 100k
Q1 | Q_NMOS_DGS
L1 | Ferrite_Bead | Resistors_SMD:R_0201 | http://www.farnell.com/datasheets/1740433.pdf
C8 | 10u
SW1 | SW_Push
U3 | ATXMEGA32A4U-MH | VQFN44
U1 | LM75
C1 | 0.1u
R11 | 10k | Resistors_SMD:R_0201 | http://www.farnell.com/datasheets/2549522.pdf
C10 | 0.1u
C11 | 0.1u
C5 | CP1
D9 | D_Schottky
C9 | .1u
U2 | LM75
C2 | 0.1u
R12 | 10k | Resistors_SMD:R_0201 | http://www.farnell.com/datasheets/2549522.pdf
R14 | 10k | Resistors_SMD:R_0201 | http://www.farnell.com/datasheets/2549522.pdf
D11 | D_Zener
D12 | D_Zener
D13 | D_Zener
D14 | D_Zener
R10 | 10k | Resistors_SMD:R_0201 | http://www.farnell.com/datasheets/2549522.pdf
R13 | 10k | Resistors_SMD:R_0201 | http://www.farnell.com/datasheets/2549522.pdf
R15 | 10k | Resistors_SMD:R_0201 | http://www.farnell.com/datasheets/2549522.pdf
C6 | 10u
C7 | .1u
D10 | D_Zener
R21 | 1k | Resistors_SMD:R_1206 | https://nl.mouser.com/datasheet/2/427/rcge3-254226.pdf
R22 | 1k | Resistors_SMD:R_1206 | https://nl.mouser.com/datasheet/2/427/rcge3-254226.pdf
R23 | 1k | Resistors_SMD:R_1206 | https://nl.mouser.com/datasheet/2/427/rcge3-254226.pdf
R24 | 1k | Resistors_SMD:R_1206 | https://nl.mouser.com/datasheet/2/427/rcge3-254226.pdf
R25 | 1k | Resistors_SMD:R_1206 | https://nl.mouser.com/datasheet/2/427/rcge3-254226.pdf
R28 | 10k | Resistors_SMD:R_1206 | https://nl.mouser.com/datasheet/2/427/rcge3-254226.pdf
R31 | 1M | Resistors_SMD:R_1206
R33 | 1M | Resistors_SMD:R_1206 | https://nl.mouser.com/datasheet/2/427/rcge3-254226.pdf
R34 | 1M | Resistors_SMD:R_1206 | https://nl.mouser.com/datasheet/2/427/rcge3-254226.pdf
R32 | 100 | Resistors_SMD:R_1206 | https://nl.mouser.com/datasheet/2/427/rcge3-254226.pdf
Q2 | BSZ105N04NSGATMA1 | TO_SOT_Packages_THT:TO-92_Molded_Narrow | https://www.infineon.com/dgdl/Infineon-BSZ105N04NSG-DS-v02_00-en.pdf?fileId=db3a30431689f4420116c485c67f084e
Q4 | BSZ105N04NSGATMA1 | TO_SOT_Packages_THT:TO-92_Molded_Narrow | https://www.infineon.com/dgdl/Infineon-BSZ105N04NSG-DS-v02_00-en.pdf?fileId=db3a30431689f4420116c485c67f084e
Q3 | NVR1P02T1G | TO_SOT_Packages_THT:TO-220_Vertical | https://docs-emea.rs-online.com/webdocs/12e2/0900766b812e287b.pdf
C16 | 1uF | Capacitors_THT:CP_Radial_D22.0mm_P10.00mm_SnapIn | https://docs-emea.rs-online.com/webdocs/13ec/0900766b813ec20a.pdf
C14 | 1uF | Capacitors_THT:CP_Radial_D22.0mm_P10.00mm_SnapIn | https://docs-emea.rs-online.com/webdocs/13ec/0900766b813ec20a.pdf
C13 | 1uF | Capacitors_THT:CP_Radial_D22.0mm_P10.00mm_SnapIn | https://docs-emea.rs-online.com/webdocs/13ec/0900766b813ec20a.pdf
C12 | 1uF | Capacitors_THT:CP_Radial_D22.0mm_P10.00mm_SnapIn | https://docs-emea.rs-online.com/webdocs/13ec/0900766b813ec20a.pdf
C20 | 1uF | Capacitors_THT:CP_Radial_D22.0mm_P10.00mm_SnapIn | https://docs-emea.rs-online.com/webdocs/13ec/0900766b813ec20a.pdf
C21 | 1uF | Capacitors_THT:CP_Radial_D22.0mm_P10.00mm_SnapIn | https://docs-emea.rs-online.com/webdocs/13ec/0900766b813ec20a.pdf
C22 | 1uF | Capacitors_THT:CP_Radial_D22.0mm_P10.00mm_SnapIn | https://docs-emea.rs-online.com/webdocs/13ec/0900766b813ec20a.pdf
C23 | 1uF | Capacitors_THT:CP_Radial_D22.0mm_P10.00mm_SnapIn | https://docs-emea.rs-online.com/webdocs/13ec/0900766b813ec20a.pdf
MMDL301T1G1 | D |  | https://www.onsemi.com/pub/Collateral/MMDL301T1-D.PDF
D_zener1 | ds18010 |  | https://www.diodes.com/assets/Datasheets/ds18010.pdf
R29 | 10k Thermistor |  | https://nl.mouser.com/datasheet/2/362/semitec_atthermistor-1202913.pdf
X1 | bq78350-R1 |  | http://www.ti.com/lit/ds/symlink/bq78350-r1.pdf
R36 | R | Resistors_SMD:R_1206 | https://nl.mouser.com/datasheet/2/427/rcge3-254226.pdf
R37 | R | Resistors_SMD:R_1206 | https://nl.mouser.com/datasheet/2/427/rcge3-254226.pdf
R38 | R | Resistors_SMD:R_1206 | https://nl.mouser.com/datasheet/2/427/rcge3-254226.pdf
R39 | R | Resistors_SMD:R_1206 | https://nl.mouser.com/datasheet/2/427/rcge3-254226.pdf
Q5 | Q_PJFET_SDG
Q6 | Q_NJFET_SDG
R40 | 100k | Resistors_SMD:R_1206 | https://nl.mouser.com/datasheet/2/427/rcge3-254226.pdf
C24 | 0.1uF | Capacitors_THT:CP_Radial_D22.0mm_P10.00mm_SnapIn | https://docs-emea.rs-online.com/webdocs/13ec/0900766b813ec20a.pdf
D15 | LED |  | http://www.produktinfo.conrad.com/datenblaetter/175000-199999/184543-da-01-en-LED_20_5mm_rot_WU_8_53_HD.pdf
D16 | LED |  | http://www.produktinfo.conrad.com/datenblaetter/175000-199999/184543-da-01-en-LED_20_5mm_rot_WU_8_53_HD.pdf
D17 | LED |  | http://www.produktinfo.conrad.com/datenblaetter/175000-199999/184543-da-01-en-LED_20_5mm_rot_WU_8_53_HD.pdf
D18 | LED |  | http://www.produktinfo.conrad.com/datenblaetter/175000-199999/184543-da-01-en-LED_20_5mm_rot_WU_8_53_HD.pdf
D19 | LED |  | http://www.produktinfo.conrad.com/datenblaetter/175000-199999/184543-da-01-en-LED_20_5mm_rot_WU_8_53_HD.pdf
R35 | 221k | Resistors_SMD:R_1206 | http://www.produktinfo.conrad.com/datenblaetter/1200000-1299999/001220484-da-01-en-METALLS__WID__0_6W_221K_5000ST.pdf
U5 | bq76920 |  | http://www.ti.com/lit/ds/symlink/bq76920.pdf
C15 | 1uF | Capacitors_THT:CP_Radial_D22.0mm_P10.00mm_SnapIn | https://docs-emea.rs-online.com/webdocs/13ec/0900766b813ec20a.pdf
R30 | 1M
C19 | 0.1uF | Capacitors_THT:CP_Radial_D22.0mm_P10.00mm_SnapIn | https://docs-emea.rs-online.com/webdocs/13ec/0900766b813ec20a.pdf
C17 | 0.1uF | Capacitors_THT:CP_Radial_D22.0mm_P10.00mm_SnapIn | https://docs-emea.rs-online.com/webdocs/13ec/0900766b813ec20a.pdf
C18 | 0.1uF | Capacitors_THT:CP_Radial_D22.0mm_P10.00mm_SnapIn | https://docs-emea.rs-online.com/webdocs/13ec/0900766b813ec20a.pdf
PE2512FKE7W0R01Z1 | 10m | Resistors_SMD:R_1206 | https://nl.mouser.com/datasheet/2/447/PYu-PE_521_RoHS_L_5-1077989.pdf
R27 | 100 | Resistors_SMD:R_1206 | https://nl.mouser.com/datasheet/2/427/rcge3-254226.pdf
R26 | 100 | Resistors_SMD:R_1206 | https://nl.mouser.com/datasheet/2/427/rcge3-254226.pdf
C25 | 0.1uF | Capacitors_THT:CP_Radial_D22.0mm_P10.00mm_SnapIn | https://docs-emea.rs-online.com/webdocs/13ec/0900766b813ec20a.pdf
R50 | 10
R56 | 10
F5 | Polyfuse
R61 | 150k
R62 | 51k
R59 | 100k
R60 | 100k
F1 | Polyfuse
R57 | 100k
R58 | 100k
R53 | 1.5m
C38 | 1u
INA1 | INA226
R48 | 1k
R54 | 1k
R44 | 10k
R46 | 10k
F2 | Polyfuse
R51 | 5m R_Shunt
C36 | C
F3 | Polyfuse
INA2 | INA226
R49 | 1k
R55 | 1k
R45 | 10k
R47 | 10k
F4 | Polyfuse
R52 | 5m R_Shunt
C37 | C
Css1 | 15nF
Rt1 | 23.2k
Rmode1 | 93.1k
Cin1 | 10uF
M1 | CSD17310Q5A | TO_SOT_Packages_THT:TO-92_Molded_Narrow
M2 | CSD18514Q5A | TO_SOT_Packages_THT:TO-92_Molded_Narrow
M3 | CSD16321Q5 | TO_SOT_Packages_THT:TO-92_Molded_Narrow
M4 | CSD18511Q5A | TO_SOT_Packages_THT:TO-92_Molded_Narrow
Cboot1 | 100nF
Dboot1 | Zener
L3 | 2.20uH
Ccs1 | 47pF
Rcsp1 | 100
Rcsg1 | 100
Rsense1 | 6m
Cboot2 | 100nF
Dboot2 | Zener
Cslope1 | 110pF
Ccomp1 | 91pF
Ccomp2 | 15nF
Rcomp1 | 10.2k
Rfbt1 | 383k
Rfbb1 | 20k
U7 | LM5176 | Housings_SSOP:HTSSOP-28_4.4x9.7mm_Pitch0.65mm_ThermalPad | http://www.ti.com/lit/ds/symlink/lm5176.pdf
Coutx1 | 22uF
Coutx2 | 22uF
Coutx3 | 22uF
Cvcc1 | 1uF
Rpg1 | 10k
Cbulk1 | 68uF
Df1 | Zener
Rf1 | 10
Cf1 | 100nF
Cout1 | CP1
LDO2 | LP38692-3V3 | TO_SOT_Packages_SMD:SOT-223-6 | http://www.ti.com/lit/ds/symlink/lp38692.pdf
LDO1 | LP38692-5V | TO_SOT_Packages_SMD:SOT-223-6 | http://www.ti.com/lit/ds/symlink/lp38692.pdf
C33 | 1uF | Capacitors_THT:CP_Radial_D22.0mm_P10.00mm_SnapIn | https://docs-emea.rs-online.com/webdocs/13ec/0900766b813ec20a.pdf
C32 | 1uF | Capacitors_THT:CP_Radial_D22.0mm_P10.00mm_SnapIn | https://docs-emea.rs-online.com/webdocs/13ec/0900766b813ec20a.pdf
C34 | 1uF | Capacitors_THT:CP_Radial_D22.0mm_P10.00mm_SnapIn | https://docs-emea.rs-online.com/webdocs/13ec/0900766b813ec20a.pdf
C35 | 1uF | Capacitors_THT:CP_Radial_D22.0mm_P10.00mm_SnapIn | https://docs-emea.rs-online.com/webdocs/13ec/0900766b813ec20a.pdf
L2 | 3.3uH
R43 | 75k | Resistors_SMD:R_1206 | https://nl.mouser.com/datasheet/2/427/rcge3-254226.pdf
R41 | 10k | Resistors_SMD:R_1206 | https://nl.mouser.com/datasheet/2/447/PYu-RC_Group_51_RoHS_L_9-1314892.pdf
R42 | 10k | Resistors_SMD:R_1206 | https://nl.mouser.com/datasheet/2/447/PYu-RC_Group_51_RoHS_L_9-1314892.pdf
C30 | 0.1uF | Capacitors_THT:CP_Radial_D22.0mm_P10.00mm_SnapIn | https://docs-emea.rs-online.com/webdocs/13ec/0900766b813ec20a.pdf
C28 | 10uF | Capacitors_THT:CP_Radial_D22.0mm_P10.00mm_SnapIn | https://docs-emea.rs-online.com/webdocs/13ec/0900766b813ec20a.pdf
C26 | 22uF | Capacitors_THT:CP_Radial_D22.0mm_P10.00mm_SnapIn | https://docs-emea.rs-online.com/webdocs/13ec/0900766b813ec20a.pdf
C27 | 22uF | Capacitors_THT:CP_Radial_D22.0mm_P10.00mm_SnapIn | https://docs-emea.rs-online.com/webdocs/13ec/0900766b813ec20a.pdf
C31 | 0.1uF | Capacitors_THT:CP_Radial_D22.0mm_P10.00mm_SnapIn | https://docs-emea.rs-online.com/webdocs/13ec/0900766b813ec20a.pdf
C29 | 10uF | Capacitors_THT:CP_Radial_D22.0mm_P10.00mm_SnapIn | https://docs-emea.rs-online.com/webdocs/13ec/0900766b813ec20a.pdf
U6 | TPS565201 | TO_SOT_Packages_SMD:SOT-23-6 | http://www.ti.com/lit/ds/symlink/tps565201.pdf
U8 | INA300 |  | http://www.ti.com/lit/ds/symlink/ina300-q1.pdf
U9 | LTC4412 | TO_SOT_Packages_SMD:TSOT-23-6 | http://www.analog.com/media/en/technical-documentation/data-sheets/4412fb.pdf
Q8 | IPD85P04P4-07 | TO_SOT_Packages_SMD:TO-252-3_TabPin2 | https://nl.mouser.com/datasheet/2/196/IPD85P04P4-07_DS_10-349929.pdf
R66 | 470k | Resistors_SMD:R_0805_HandSoldering
Q7 | IPD85P04P4-07 | TO_SOT_Packages_SMD:TO-252-3_TabPin2 | https://nl.mouser.com/datasheet/2/196/IPD85P04P4-07_DS_10-349929.pdf
U11 | LT1370 | Power_Integrations:TO-220-7C | http://www.analog.com/media/en/technical-documentation/data-sheets/1370fs.pdf
C43 | 470u | Capacitors_SMD:C_0805_HandSoldering
C47 | 4.7n | Capacitors_SMD:C_0805_HandSoldering
C44 | 4.7n | Capacitors_SMD:C_0805_HandSoldering
R67 | 2k | Resistors_SMD:R_0805_HandSoldering
L4 | 22u | Inductors_SMD:L_1806_Handsoldering
C48 | 47u | Capacitors_SMD:C_0805_HandSoldering
D20 | PMEG100V060ELPDZ | footprints:CFP15 | https://assets.nexperia.com/documents/data-sheet/PMEG100V060ELPD.pdf
L6 | 22u | Inductors_SMD:L_1806_Handsoldering
R70 | 60k | Resistors_SMD:R_0805_HandSoldering
R65 | 11k | Resistors_SMD:R_0805_HandSoldering
C51 | 470u | Capacitors_SMD:CP_Elec_8x10
L5 | 22u | Inductors_SMD:L_1806_Handsoldering
C49 | 47u | Capacitors_SMD:C_0805_HandSoldering
L7 | 22u | Inductors_SMD:L_1806_Handsoldering
Q9 | BSS316N H6327 | TO_SOT_Packages_SMD:SOT-23 | https://nl.mouser.com/datasheet/2/196/BSS316N_Rev2.3-63035.pdf
D21 | MBR360G | Diodes_THT:D_DO-201_P15.24mm_Horizontal | https://www.onsemi.com/pub/Collateral/MBR350-D.PDF
C50 | 470u | Capacitors_SMD:CP_Elec_8x10
U10 | AD5121 | Universal:LFCSP 20 | https://nl.mouser.com/datasheet/2/609/AD5121_5141-877035.pdf
C41 | 0.1u | Capacitors_SMD:C_0805_HandSoldering
C45 | 10u | Capacitors_SMD:C_0805_HandSoldering
C42 | 0.1u | Capacitors_SMD:C_0805_HandSoldering
C46 | 10u | Capacitors_SMD:C_0805_HandSoldering
C39 | 0.1u | Capacitors_SMD:C_0805_HandSoldering
C40 | 10u | Capacitors_SMD:C_0805_HandSoldering
R68 | 12k | Resistors_SMD:R_0805_HandSoldering
R69 | 10k | Resistors_SMD:R_0805_HandSoldering
R63 | 63k | Resistors_SMD:R_0805_HandSoldering
R64 | 10k | Resistors_SMD:R_0805_HandSoldering
Q10 | IPD85P04P4-07 | TO_SOT_Packages_SMD:TO-252-3_TabPin2 | https://nl.mouser.com/datasheet/2/196/IPD85P04P4-07_DS_10-349929.pdf
Q11 | IPD85P04P4-07 | TO_SOT_Packages_SMD:TO-252-3_TabPin2 | https://nl.mouser.com/datasheet/2/196/IPD85P04P4-07_DS_10-349929.pdf
U12 | LM3480-3.3 | TO_SOT_Packages_SMD:SOT-23 | http://www.ti.com/lit/ds/symlink/lm3480.pdf
C53 | 1u
C52 | 1u
C58 | 15n | Capacitors_SMD:C_0805_HandSoldering
C59 | 15n | Capacitors_SMD:C_0805_HandSoldering
C56 | 47n | Capacitors_SMD:C_0805_HandSoldering
C57 | 47n | Capacitors_SMD:C_0805_HandSoldering
R72 | 10k | Resistors_SMD:R_1218_HandSoldering
R73 | 10k | Resistors_SMD:R_1218_HandSoldering
R74 | 10k | Resistors_SMD:R_1218_HandSoldering
C61 | 10u | Capacitors_SMD:C_0805_HandSoldering
C63 | 10u | Capacitors_SMD:C_0805_HandSoldering
C65 | 10u | Capacitors_SMD:C_0805_HandSoldering
C67 | 0.1u | Capacitors_SMD:C_0805_HandSoldering
R75 | 36 | Resistors_SMD:R_1218_HandSoldering
C64 | 10u | Capacitors_SMD:C_0805_HandSoldering
C66 | 10u | Capacitors_SMD:C_0805_HandSoldering
C60 | 1u | Capacitors_SMD:C_0805_HandSoldering
C62 | 1u | Capacitors_SMD:C_0805_HandSoldering
R77 | 10k | Resistors_SMD:R_1218_HandSoldering
R80 | 10k | Resistors_SMD:R_1218_HandSoldering
R76 | 10k | Resistors_SMD:R_1218_HandSoldering
R79 | 5.1k | Resistors_SMD:R_1218_HandSoldering
R78 | 5.1k | Resistors_SMD:R_1218_HandSoldering
R71 | 10k | Resistors_SMD:R_1218_HandSoldering
C55 | 1.7n | Capacitors_SMD:C_0805_HandSoldering
C54 | 160u | Capacitors_SMD:C_0805_HandSoldering
U13 | P9221R | WLCSP-52:WLCSP-52_2.64x3.94mm_Pitch0.4mm | https://nl.mouser.com/datasheet/2/464/IDT_P9221-R-Datasheet_DST_20171010-1093280.pdf

Sheet: QI
Reference | Value | Footprint | Datasheet
C5 | 15n | Capacitors_SMD:C_0805_HandSoldering
C6 | 15n | Capacitors_SMD:C_0805_HandSoldering
C3 | 47n | Capacitors_SMD:C_0805_HandSoldering
C4 | 47n | Capacitors_SMD:C_0805_HandSoldering
R2 | 10k | Resistors_SMD:R_1218_HandSoldering
R3 | 10k | Resistors_SMD:R_1218_HandSoldering
R4 | 10k | Resistors_SMD:R_1218_HandSoldering
C8 | 10u | Capacitors_SMD:C_0805_HandSoldering
C11 | 10u | Capacitors_SMD:C_0805_HandSoldering
C14 | 10u | Capacitors_SMD:C_0805_HandSoldering
C12 | 0.1u | Capacitors_SMD:C_0805_HandSoldering
R5 | 36 | Resistors_SMD:R_1218_HandSoldering
C9 | 10u | Capacitors_SMD:C_0805_HandSoldering
C13 | 10u | Capacitors_SMD:C_0805_HandSoldering
C7 | 1u | Capacitors_SMD:C_0805_HandSoldering
C10 | 1u | Capacitors_SMD:C_0805_HandSoldering
R7 | 10k | Resistors_SMD:R_1218_HandSoldering
R11 | 10k | Resistors_SMD:R_1218_HandSoldering
R6 | 10k | Resistors_SMD:R_1218_HandSoldering
R9 | 5.1k | Resistors_SMD:R_1218_HandSoldering
R8 | 5.1k | Resistors_SMD:R_1218_HandSoldering
R1 | 10k | Resistors_SMD:R_1218_HandSoldering
C2 | 1.7n | Capacitors_SMD:C_0805_HandSoldering
C1 | 160u | Capacitors_SMD:C_0805_HandSoldering
U1 | P9221R | WLCSP-52:WLCSP-52_2.64x3.94mm_Pitch0.4mm | https://nl.mouser.com/datasheet/2/464/IDT_P9221-R-Datasheet_DST_20171010-1093280.pdf
