nfakkel/DeciZebroPowerSystemControl/Schematics/PDF/Powersystem Schematic.pdf

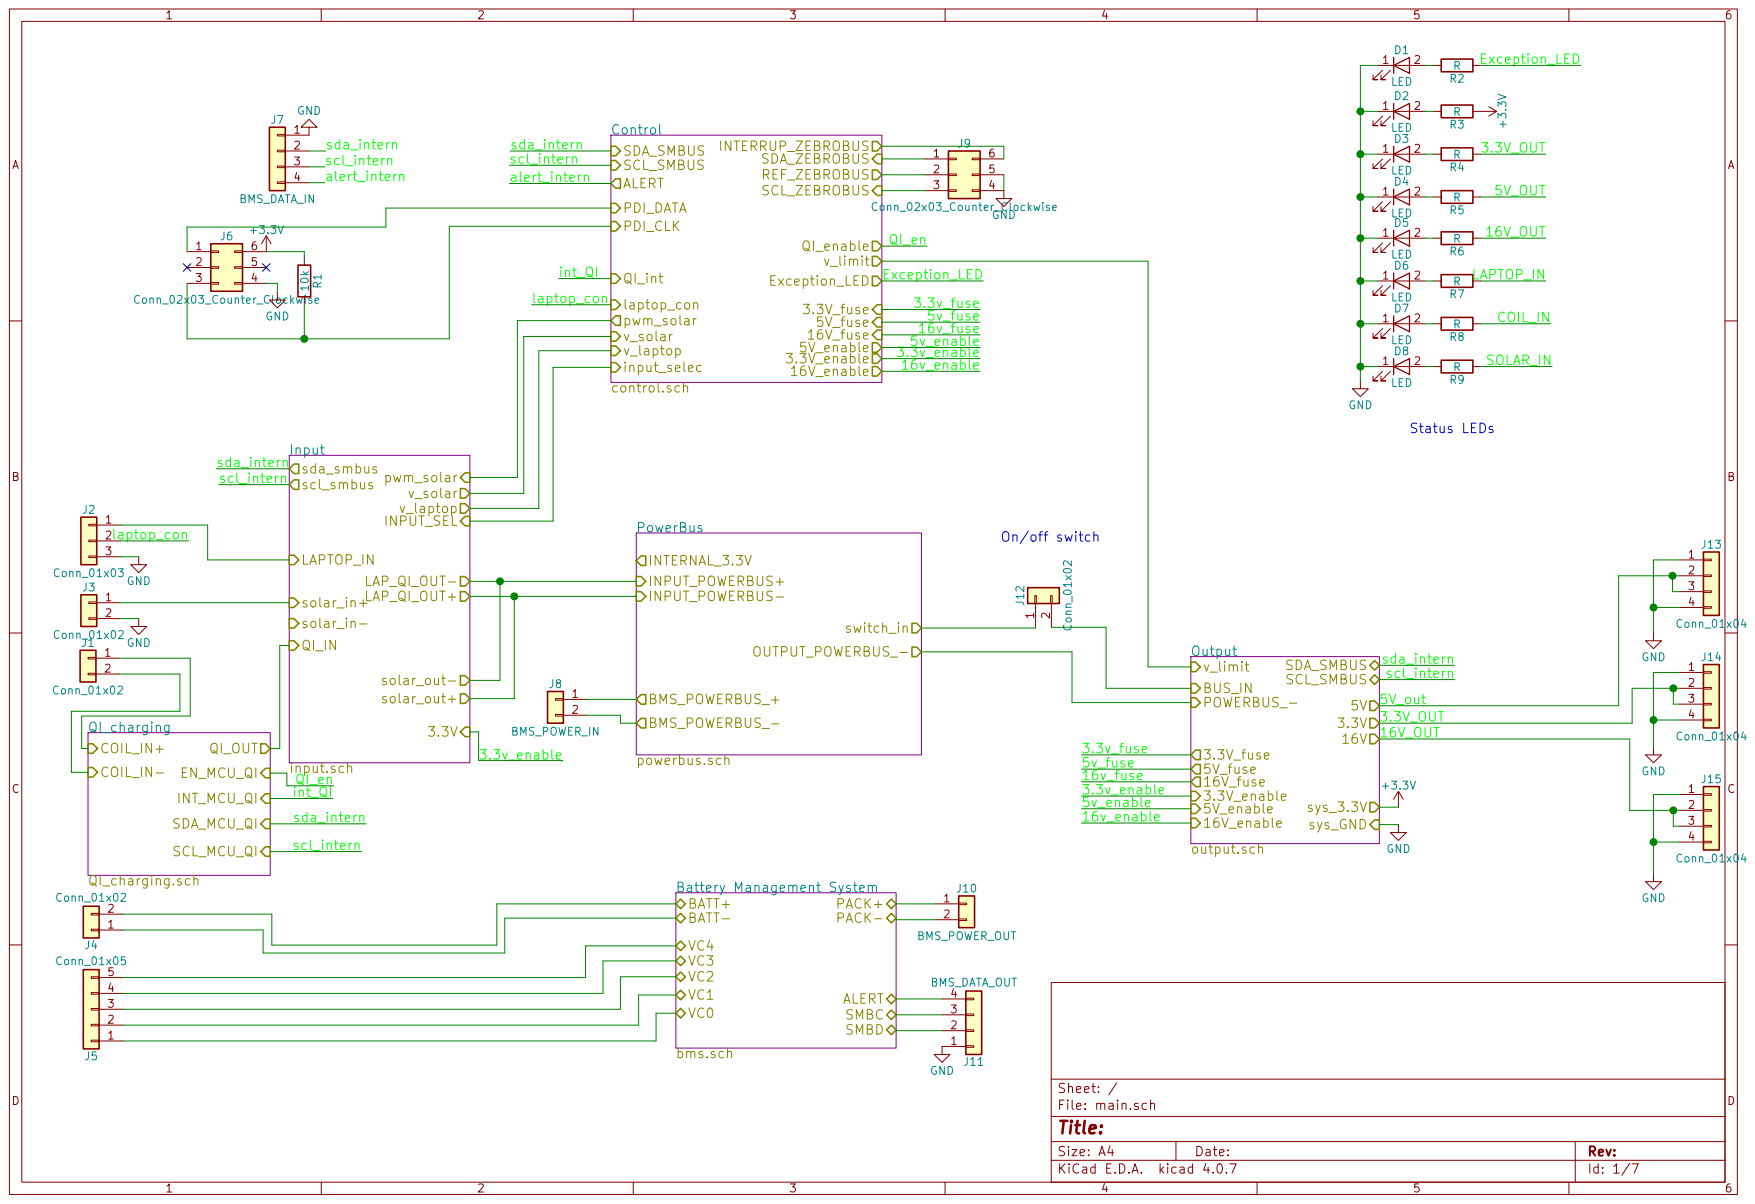
[picture p13: page 1]

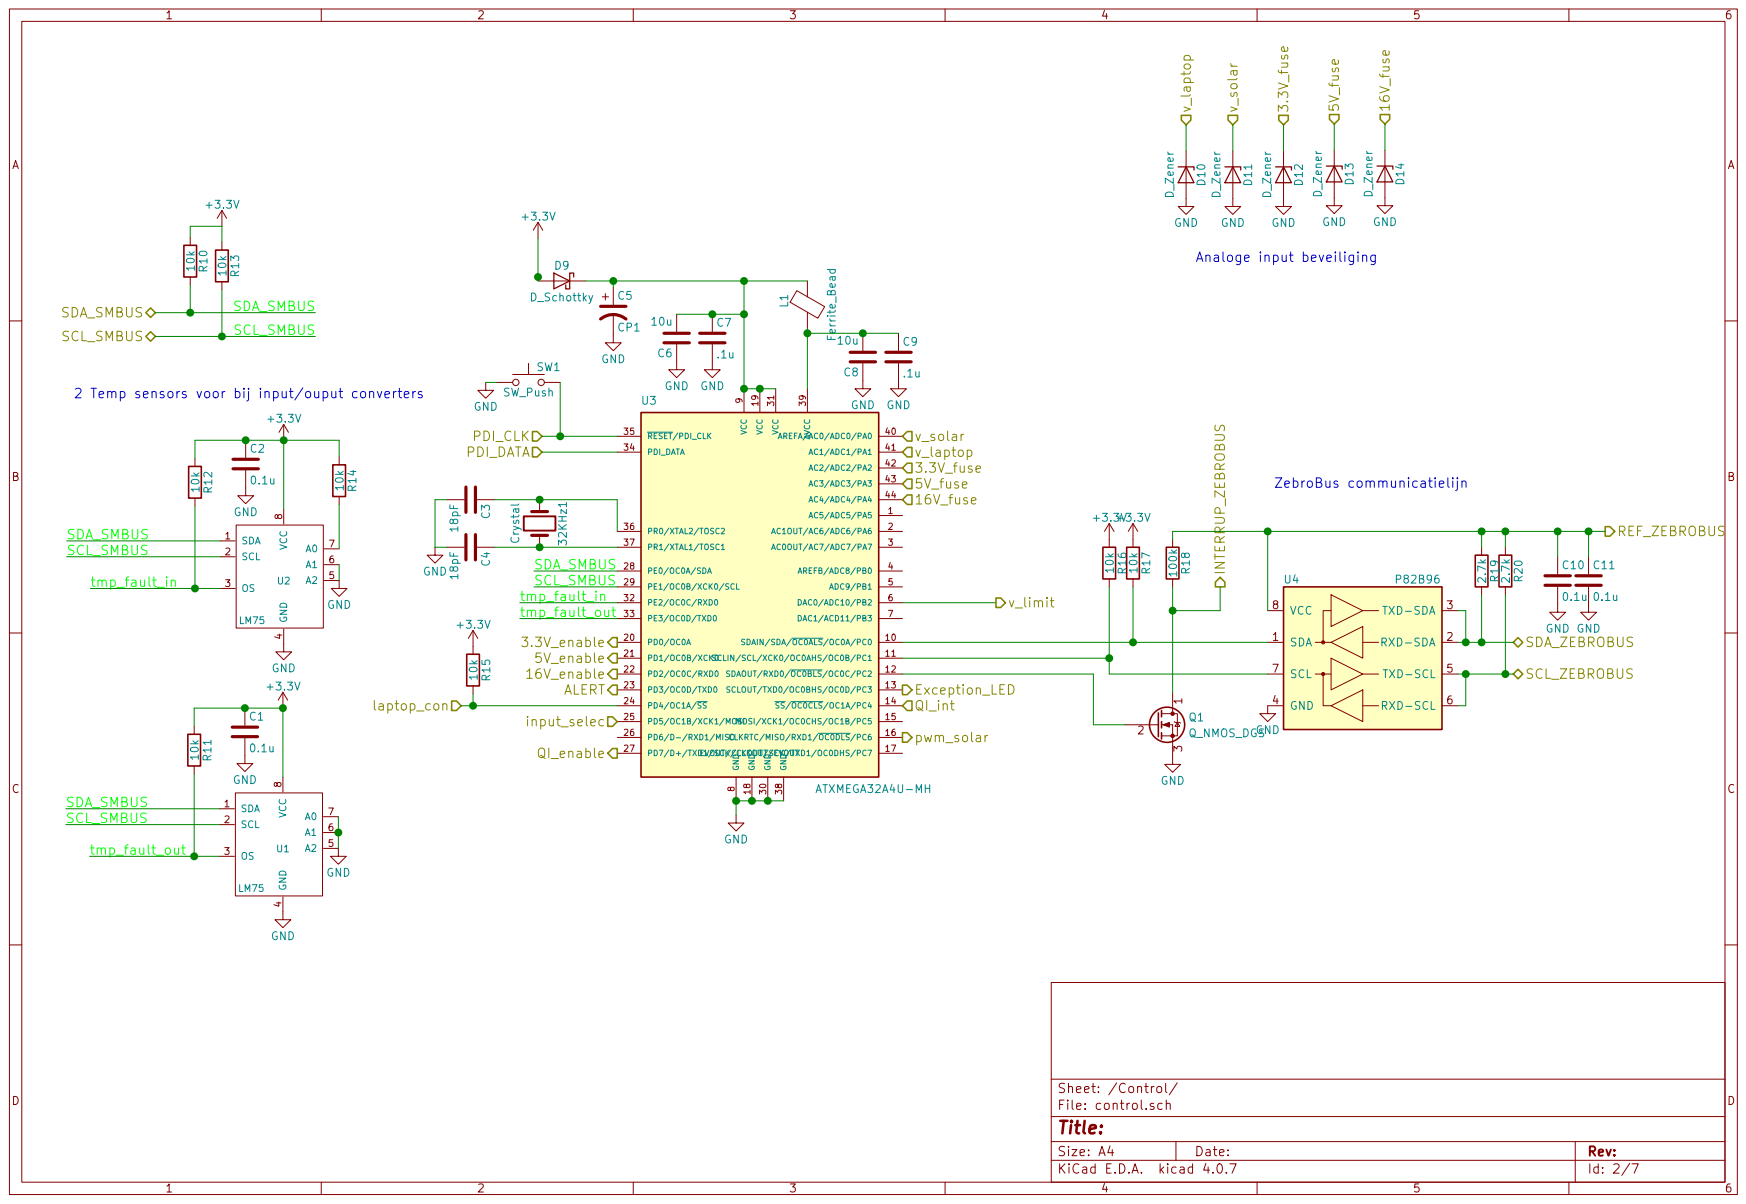
[picture p14: page 2]

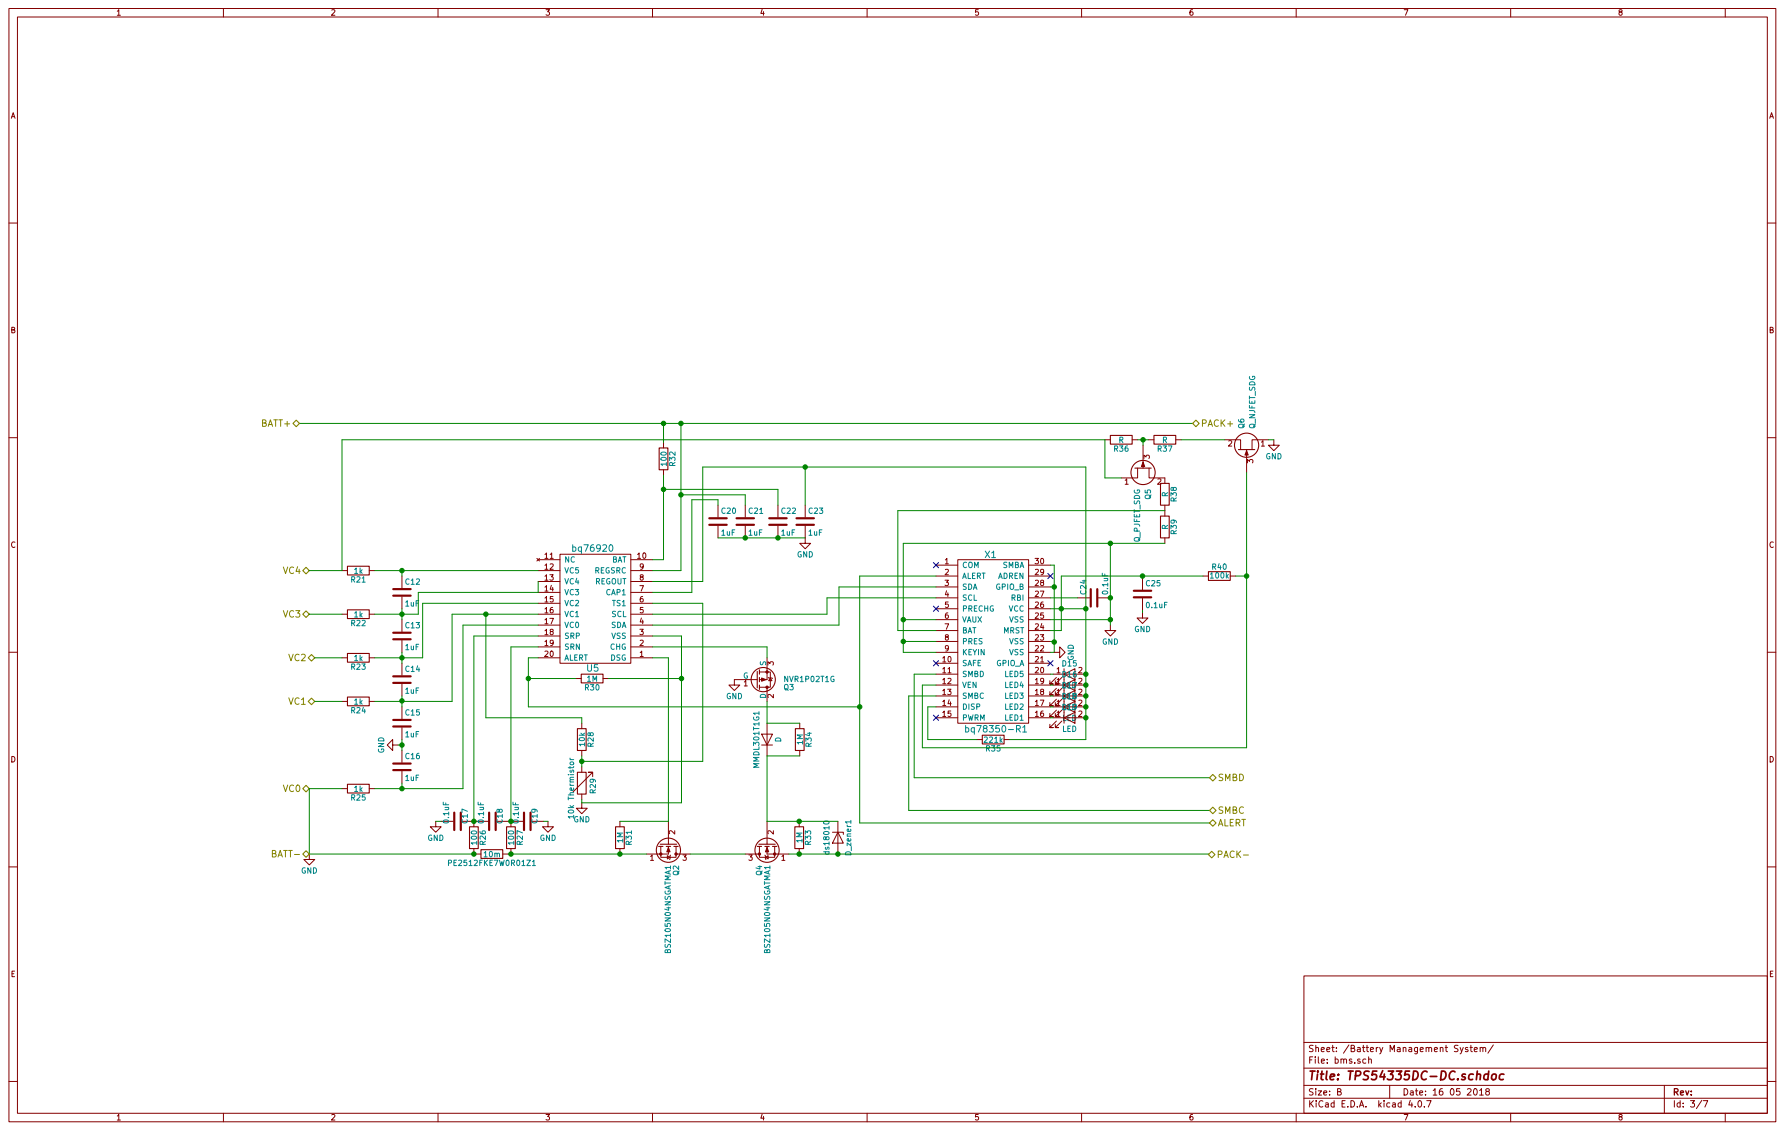
[picture p15: page 3]

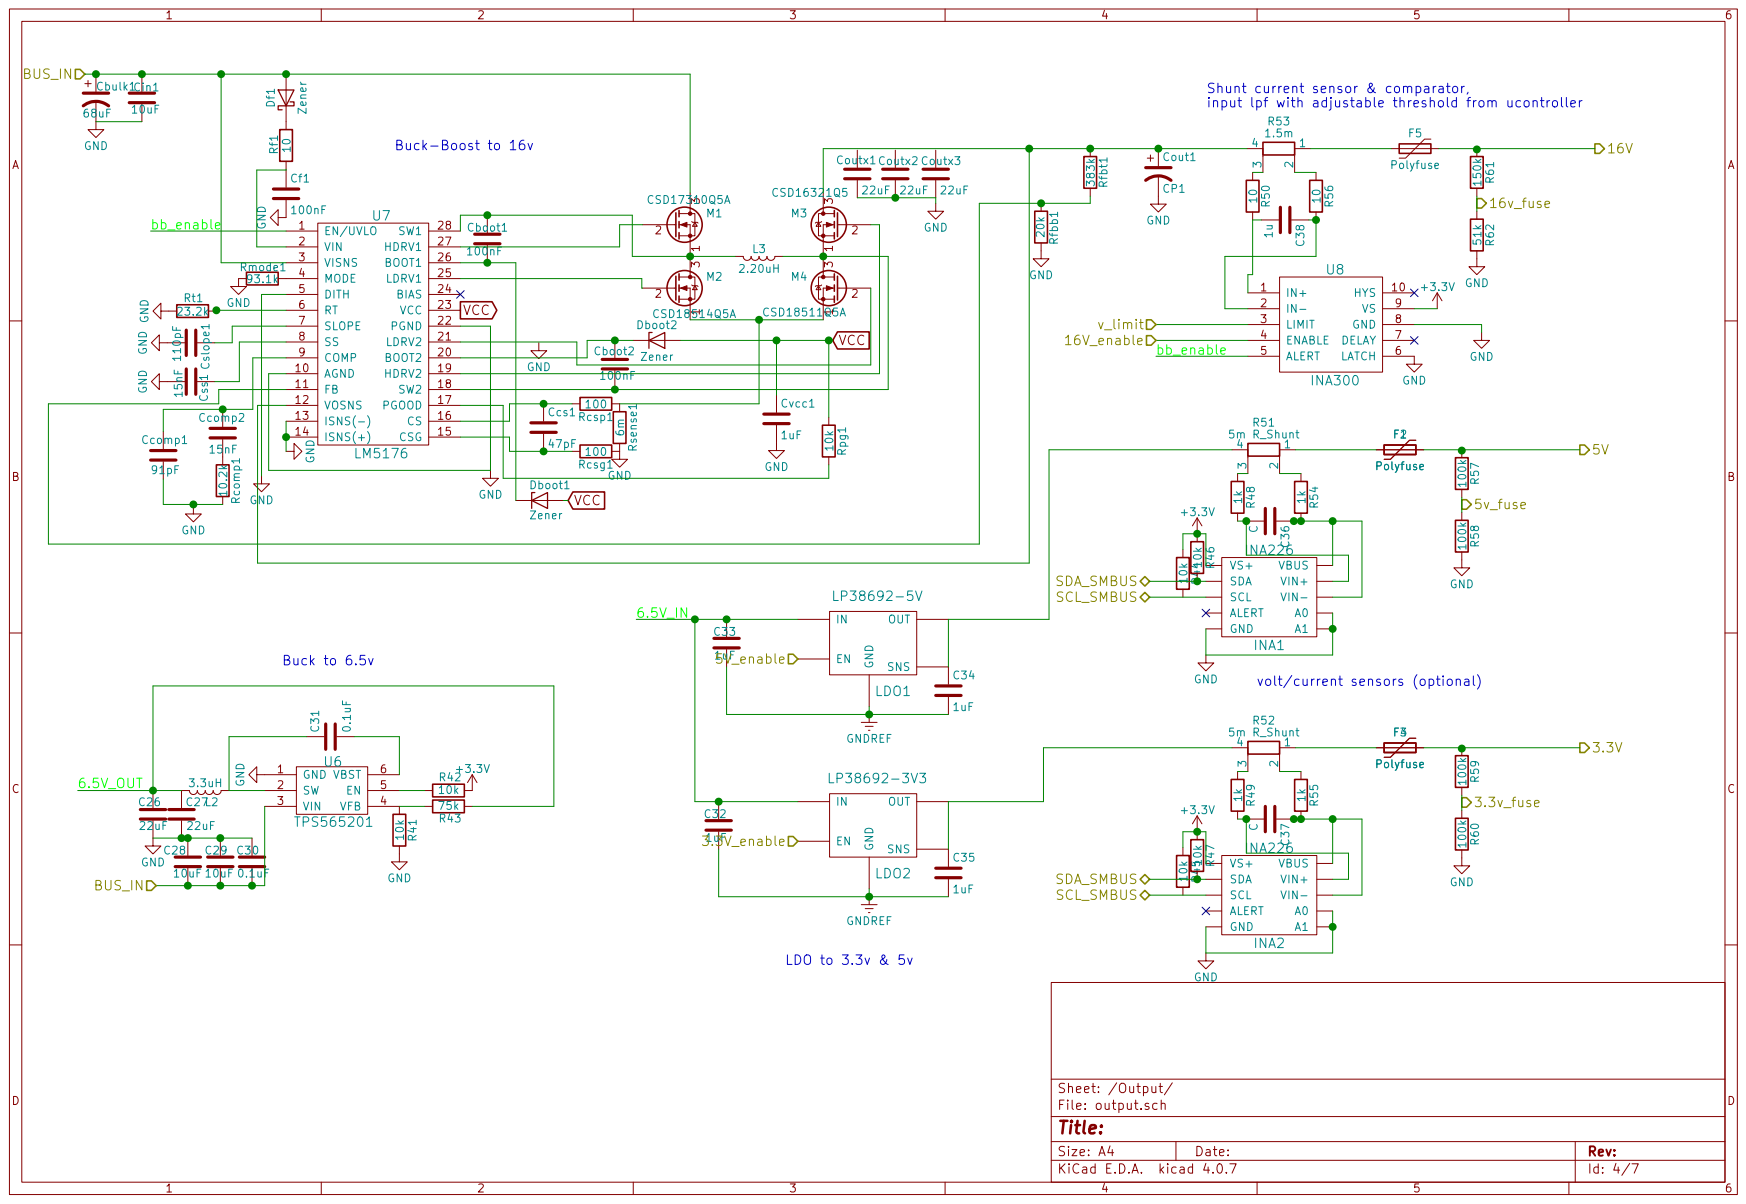
[picture p16: page 4]

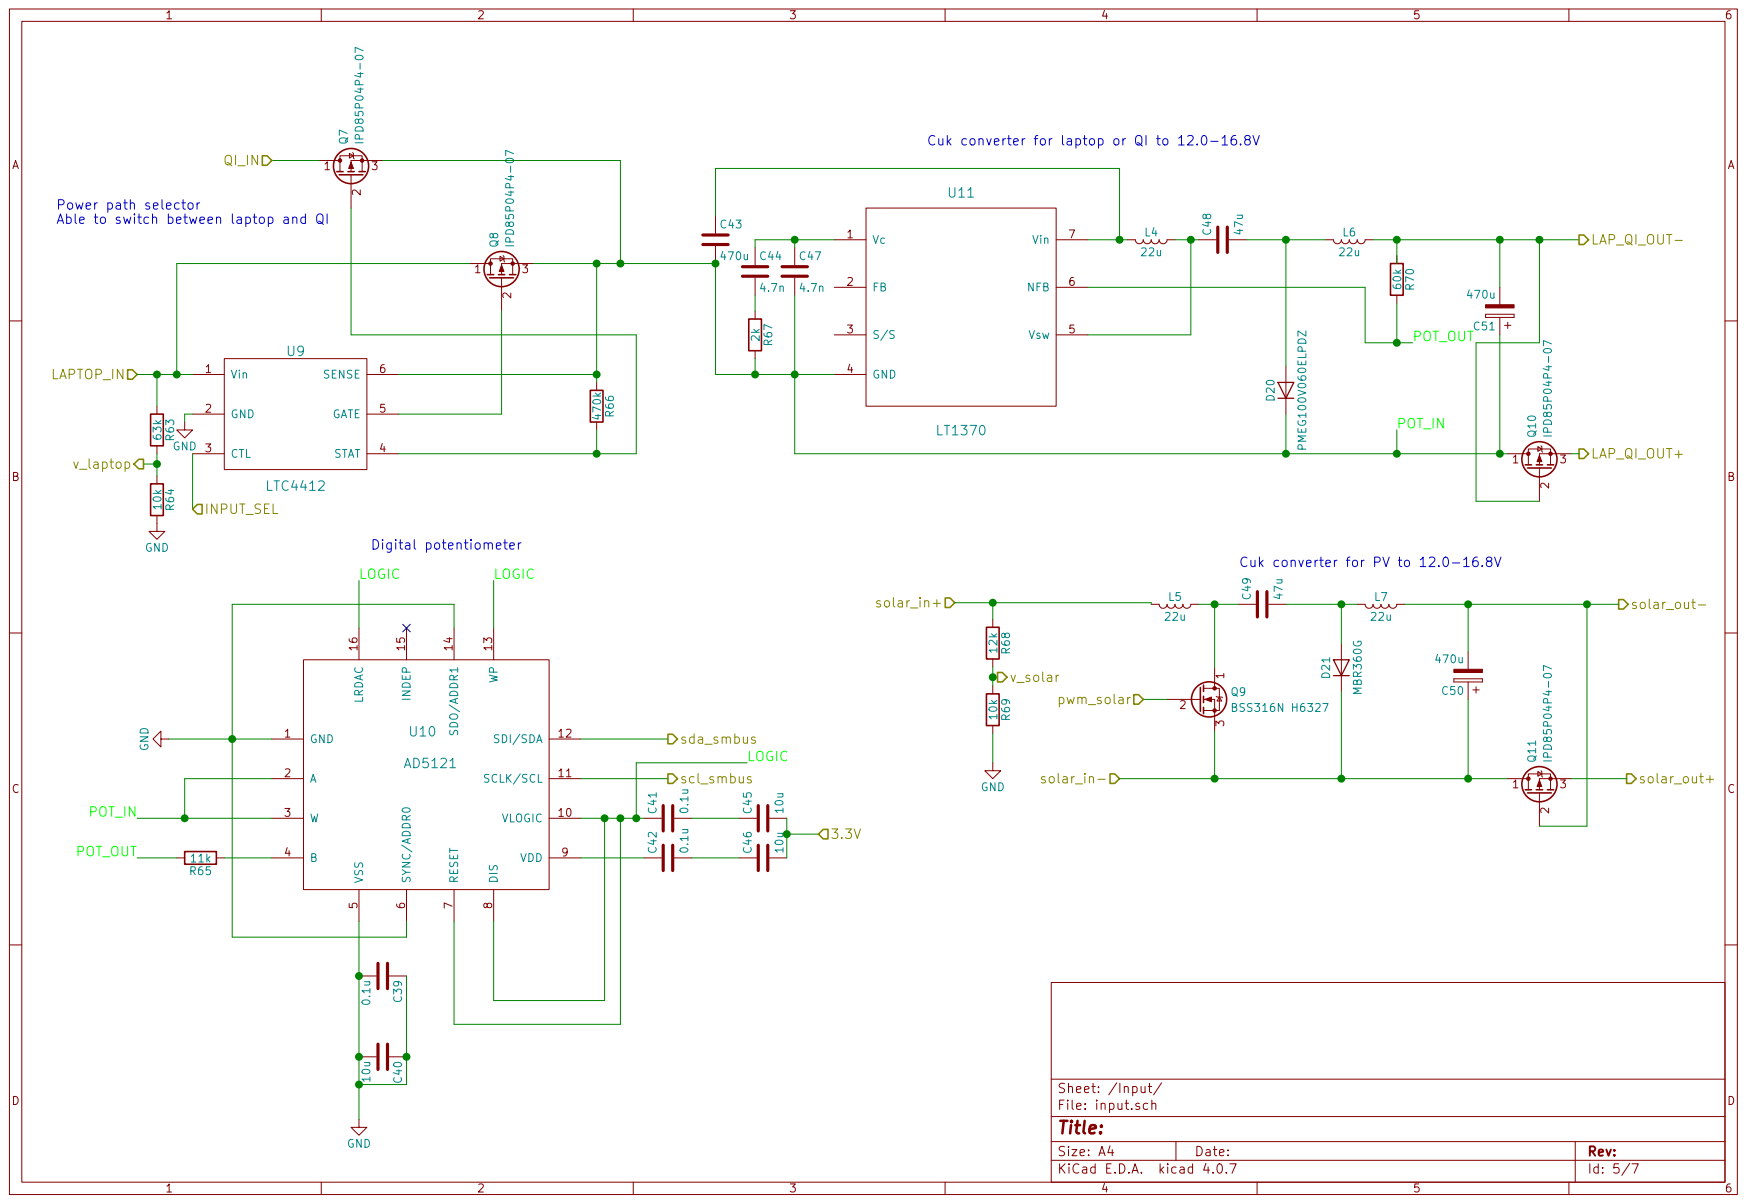
[picture p17: page 5]

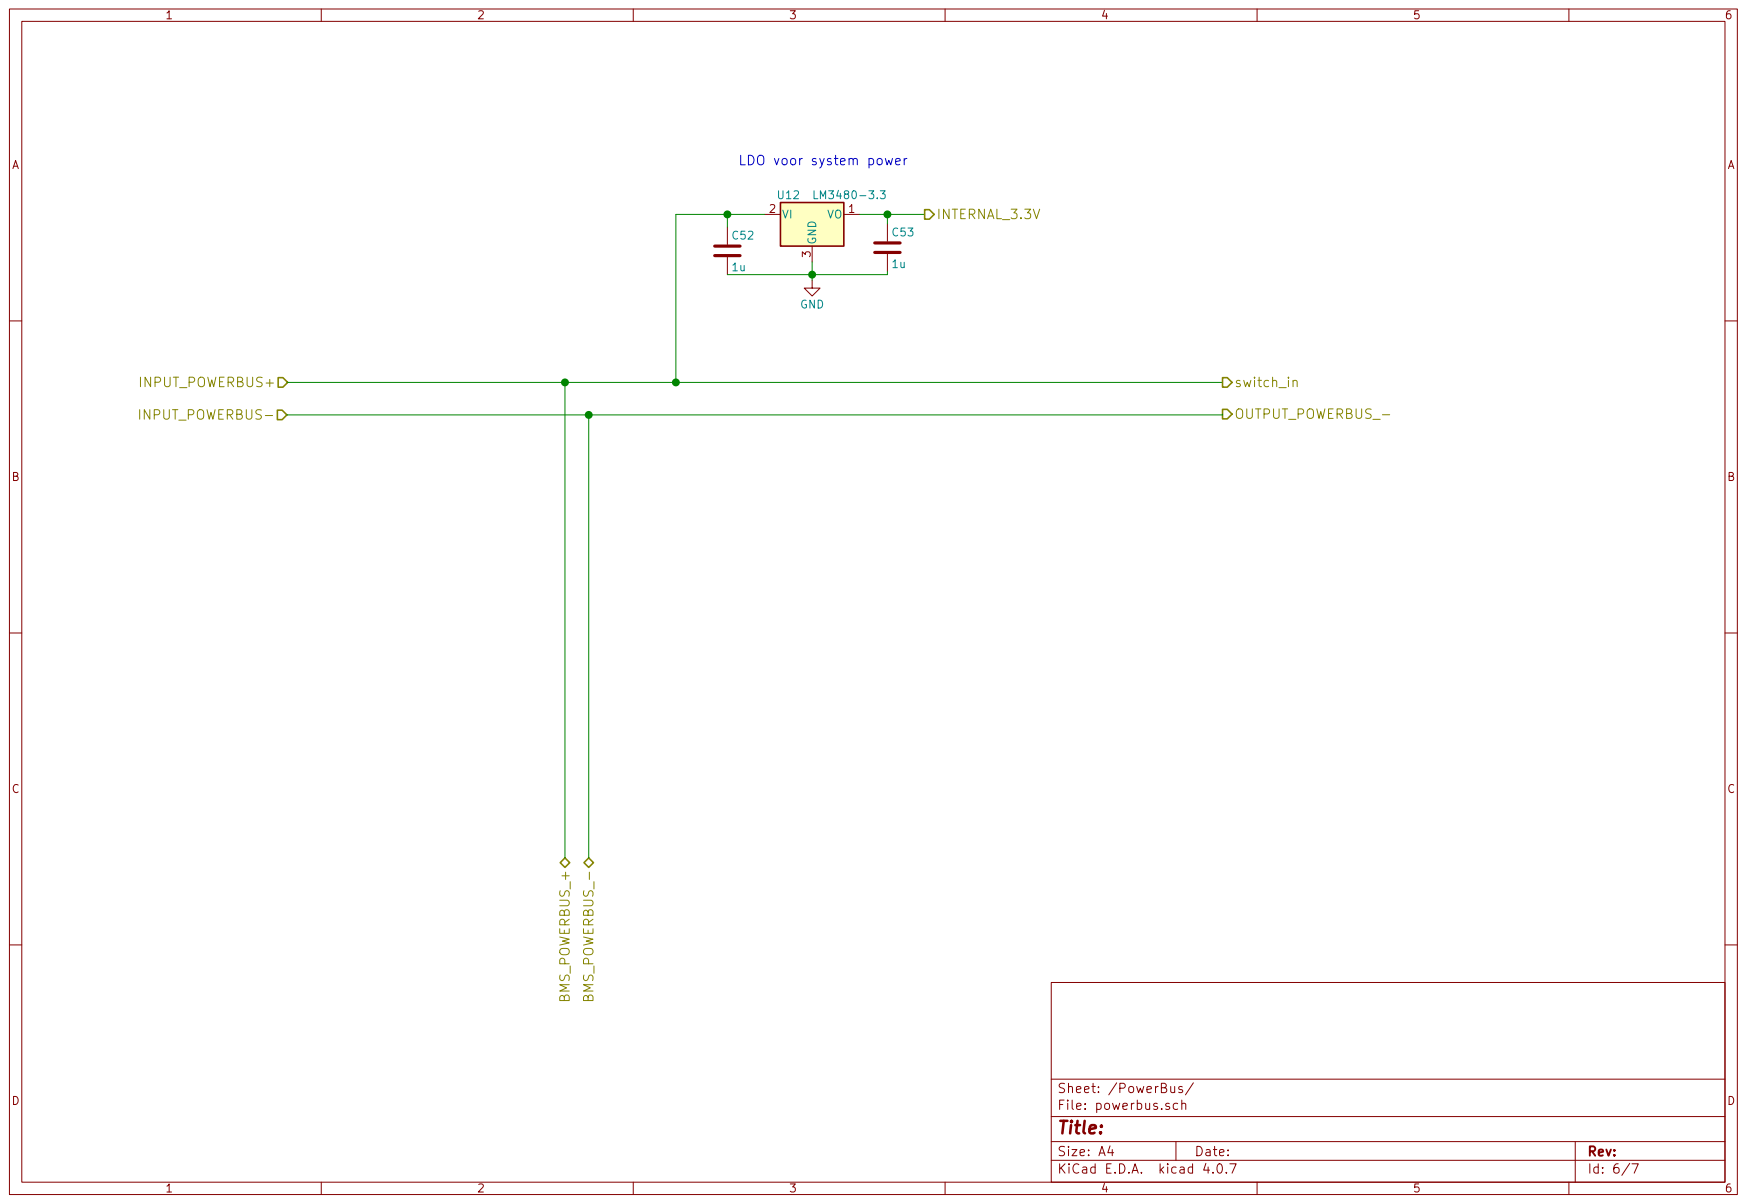
[picture p18: page 6]

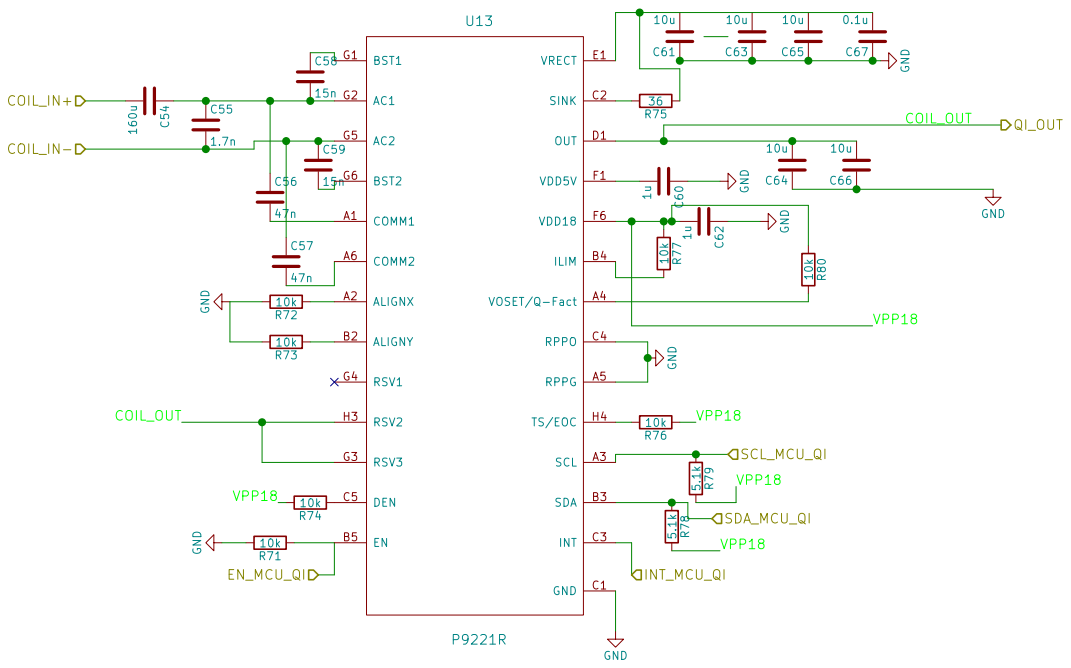
[picture p19: page 7]

Power path selector (LTC4412)

Laat automatisch de bron die aangesloten is (QI of Laptop charger) de batterij opladen via de cuk (LT1370) converter. Zorgt ervoor dat de batterijen niet tegelijkertijd via QI en de laptop charger opgeladen worden. Als zowel QI en Laptop aangesloten zijn wordt alleen via de laptop charger geladen.

Digital rheostat (AD5121)

Weerstandswaarde hiervan wordt door de microcontroller gereguleerd op basis van de powerbus spanning op een moment. Keuze van de AD5121 en de resistors er omheen laten ons de output voltage van de cuk (LT1370) bepalen tussen 12V en 16.8V (minimale en maximale powerbus voltage), volgens:
-Vout = V_NFB*(1 + R1/Rmid2) + I_NFB*(R1),
met V_NFB = -2.48V en I_NFB = -30uA. (uit datasheet LT1370)

PV cuk converter

Ontvangt PWM signaal van microcontroller. Duty cycle van PWM signaal wordt zo geregeld, dat de PV voltage constant (ongeveer 6 V voor het gekozen zonnepaneel) op de waarde blijft waarvoor PV het meeste vermogen levert. (constant voltage mppt methode)
