nfakkel/DeciZebroPowerSystemControl/Schematics/PDF/input.pdf

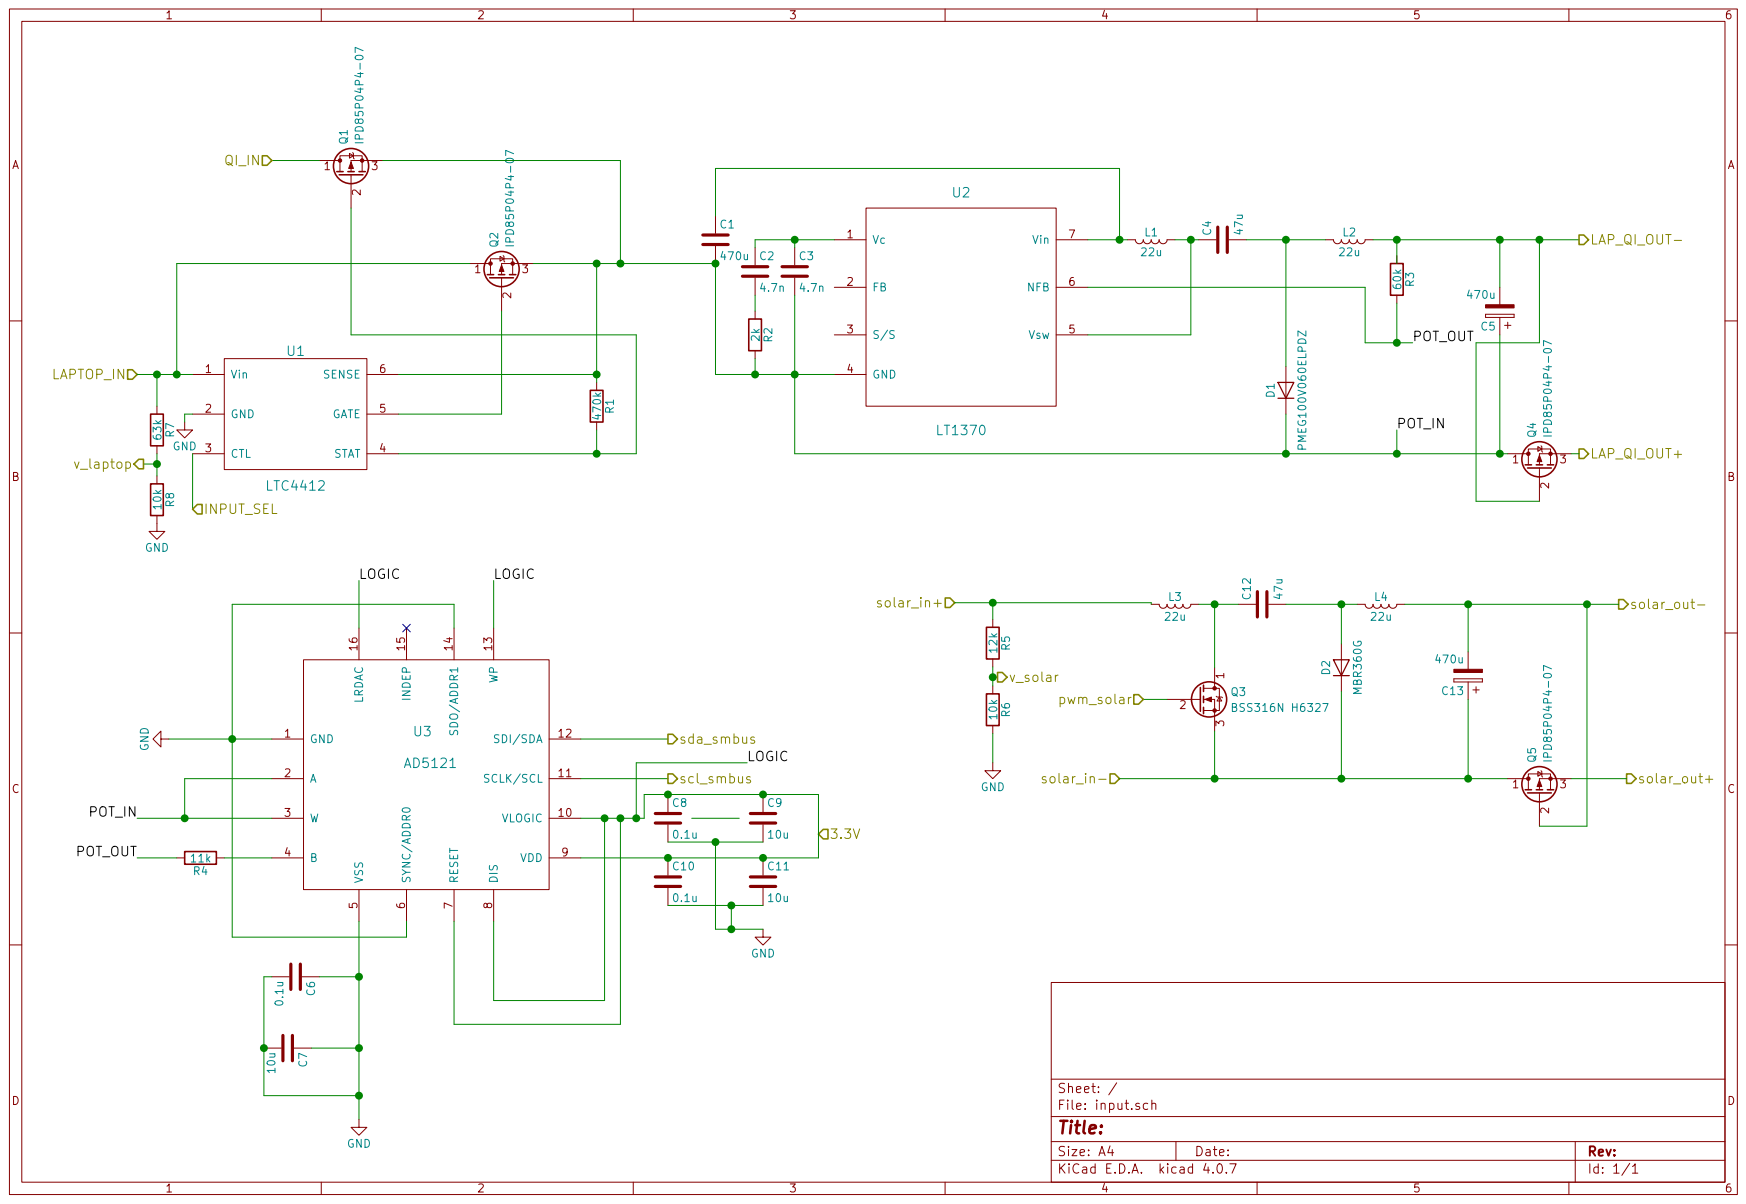
[picture p26: page 1]
