nfakkel/DeciZebroPowerSystemControl/Schematics/PDF/v1_x64_schematic.pdf

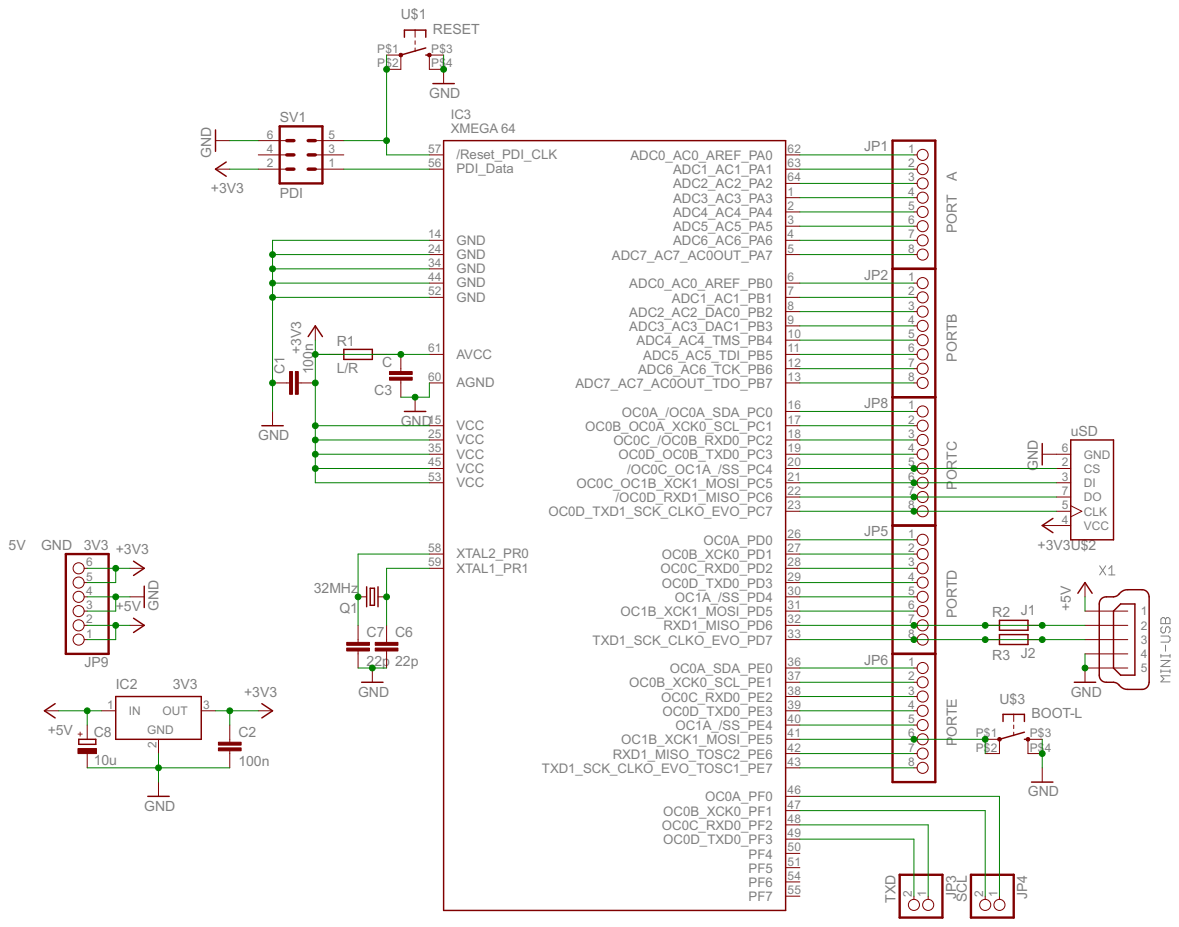
[picture p34: page 1]

24 | 5 | 8
34 | 6 JP2

22 | 7 | 7
23 | 8
