nfakkel/DeciZebroPowerSystemControl/Schematics/main.kicad_pcb

## KiCad design Schematics/main.kicad_pcb (2018-06-18)

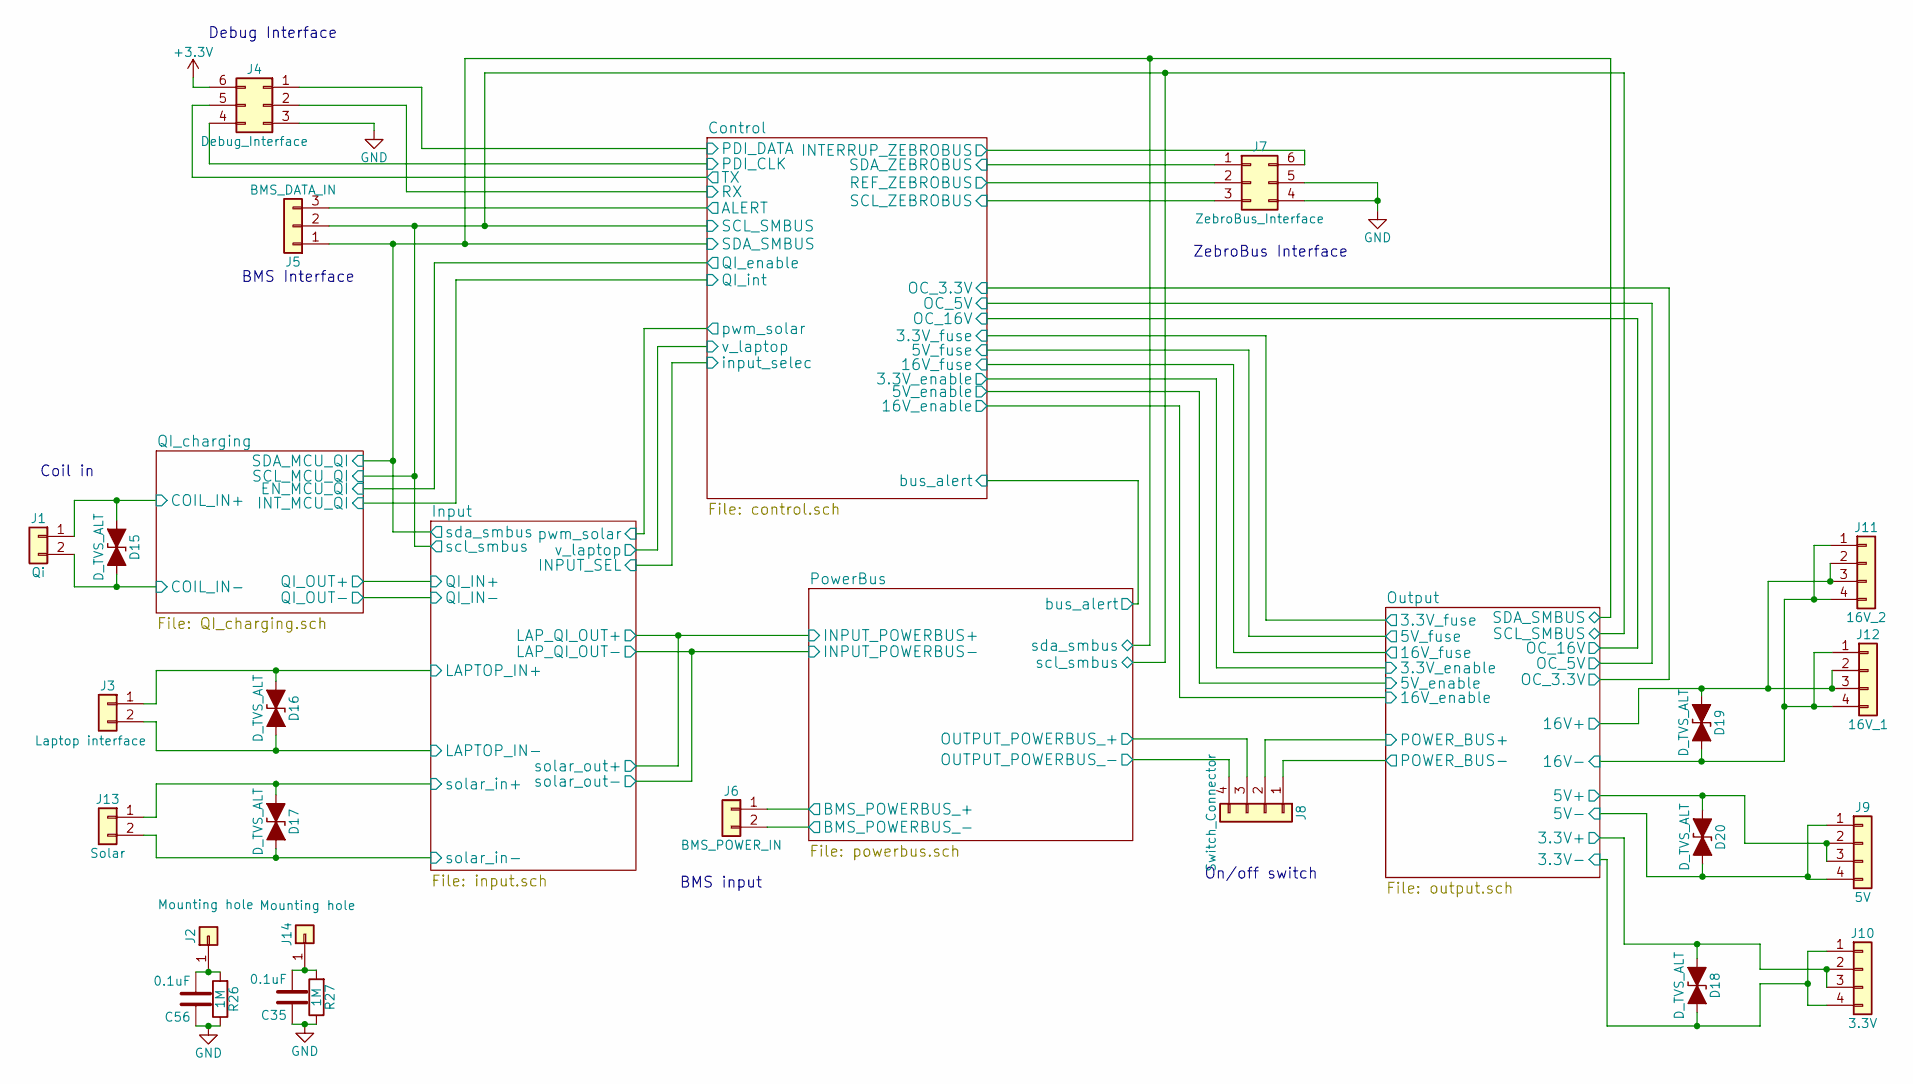
[picture p35: schematic main.sch]

Parts:
C35, C56: 0.1uF; C_0201
D15, D16, D17, D18, D19, D20: D_TVS_ALT; D_SOD-323
J1: Qi; Molex_KK-6410-02_02x2.54mm_Straight
J2, J14: Mounting hole; MountingHole_3.5mm_Pad
J3: Laptop interface; TerminalBlock_Phoenix_PT-3.5mm_2pol
J4: Debug_Interface; Pin_Header_Straight_2x03_Pitch2.54mm
J5: BMS_DATA_IN; Pin_Header_Straight_1x03_Pitch1.27mm
J6: BMS_POWER_IN; JST_VH_B2P-VH_2x3.96mm_Vertical
J7: ZebroBus_Interface; ZebroBus
J8: Switch_Connector; Molex_KK-6410-04_04x2.54mm_Straight
J9: 5V; Molex_KK-6410-04_04x2.54mm_Straight
J10: 3.3V; Molex_KK-6410-04_04x2.54mm_Straight
J11: 16V_2; Molex_KK-6410-04_04x2.54mm_Straight
J12: 16V_1; Molex_KK-6410-04_04x2.54mm_Straight
J13: Solar; Molex_KK-6410-02_02x2.54mm_Straight
R26, R27: 1M; R_0603

Connections:
+3V3: J4.6; also elsewhere on the board
/Control/ALERT: J5.3; also elsewhere on the board
/Control/INTERRUP_ZEBROBUS: J7.6; also elsewhere on the board
/Control/PDI_CLK: J4.4; also elsewhere on the board
/Control/PDI_DATA: J4.1; also elsewhere on the board
/Control/REF_ZEBROBUS: J7.2; also elsewhere on the board
/Control/RX: J4.2; also elsewhere on the board
/Control/SCL_ZEBROBUS: J7.3; also elsewhere on the board
/Control/SDA_ZEBROBUS: J7.1; also elsewhere on the board
/Control/TX: J4.5; also elsewhere on the board
/Input/LAPTOP_IN+: D16.1 (A1), J3.1; also elsewhere on the board
/Input/LAPTOP_IN-: D16.2 (A2), J3.2; also elsewhere on the board
/Input/solar_in+: D17.1 (A1), J13.1; also elsewhere on the board
/Input/solar_in-: D17.2 (A2), J13.2; also elsewhere on the board
/Output/3.3V+: D18.1 (A1), J10.2, J10.3; also elsewhere on the board
/Output/3.3V-: D18.2 (A2), D20.2 (A2), J9.1, J9.4, J10.1, J10.4; also elsewhere on the board
/Output/5V+: D20.1 (A1), J9.2, J9.3; also elsewhere on the board
/Output/16V+: D19.1 (A1), J11.2, J11.3, J12.2, J12.3; also elsewhere on the board
/Output/16V-: D19.2 (A2), J11.1, J11.4, J12.1, J12.4; also elsewhere on the board
/Output/POWER_BUS+: J8.2; also elsewhere on the board
/Output/POWER_BUS-: J8.1; also elsewhere on the board
/PowerBus/BMS_POWERBUS_+: J6.1; also elsewhere on the board
/PowerBus/BMS_POWERBUS_-: J6.2, J8.4; also elsewhere on the board
/PowerBus/OUTPUT_POWERBUS_+: J8.3; also elsewhere on the board
/QI_charging/COIL_IN+: D15.1 (A1), J1.1; also elsewhere on the board
/QI_charging/COIL_IN-: D15.2 (A2), J1.2; also elsewhere on the board
/QI_charging/SCL_MCU_QI: J5.2; also elsewhere on the board
/QI_charging/SDA_MCU_QI: J5.1; also elsewhere on the board
GND: C35.1, C56.1, J4.3, J7.4, J7.5, R26.1, R27.1; also elsewhere on the board
unnamed: C35.2, J14.1, R27.2
unnamed: C56.2, J2.1, R26.2

Notes on the sheet:
On/off switch
Debug Interface
BMS Interface
BMS input
ZebroBus Interface
Coil in

Schematic: control.sch

Parts:
C1, C2, C10: 0.1u; C_0201
C3: 1m; CP_Radial_D8.0mm_P3.50mm
C4, C5, C6, C8, C9: .1u; C_0201
C7: 10u; C_0603
D1, D12: LED; LED_0603
D2: D_Schottky; D_SOD-123F
D3, D4, D5, D6: D_Zener; SOT-23
L1: Ferrite_Bead; R_0201
Q1: Si2302CDS; SOT-23
R1, R3, R4, R5, R6: 10k; R_0201
R2, R47: 120; R_0603
R8, R9: 2.7k; R_0201
R10: 100k; R_0603
U1: LM75BD; SO-8
U2: LM75; SO-8
U3: ATXMEGA32A4U-AU; tqfp44_v1
U12: TCA9803; VSSOP-8

Connections:
+3V3: C1.1, C2.1, C9.1, D2.2 (A), R1.1, R3.1, R4.1, R5.1, R6.1, R8.1, R9.1, U1.8 (VCC), U2.8 (VCC), U12.1 (VCCA); also elsewhere on the board
/Control/3.3V_enable: U3.20 (PD0/OC0A); also elsewhere on the board
/Control/3.3V_fuse: D6.1 (K), U3.41 (AC1/ADC1/PA1); also elsewhere on the board
/Control/5V_enable: U3.21 (PD1/OC0B/XCK0); also elsewhere on the board
/Control/5V_fuse: D5.1 (K), U3.42 (AC2/ADC2/PA2); also elsewhere on the board
/Control/16V_enable: U3.22 (PD2/OC0C/RXD0); also elsewhere on the board
/Control/16V_fuse: D4.1 (K), U3.43 (AC3/ADC3/PA3); also elsewhere on the board
/Control/ALERT: U3.23 (PD3/OC0D/TXD0); also elsewhere on the board
/Control/INTERRUP_ZEBROBUS: Q1.3, R10.2; also elsewhere on the board
/Control/OC_3.3V: U3.1 (AC5/ADC5/PA5); also elsewhere on the board
/Control/OC_5V: U3.2 (AC1OUT/AC6/ADC6/PA6); also elsewhere on the board
/Control/OC_16V: U3.3 (AC0OUT/AC7/ADC7/PA7); also elsewhere on the board
/Control/PDI_CLK: U3.35 (~RESET~/PDI_CLK); also elsewhere on the board
/Control/PDI_DATA: U3.34 (PDI_DATA); also elsewhere on the board
/Control/REF_ZEBROBUS: C10.1, R10.1, U12.8 (VCCB); also elsewhere on the board
/Control/RX: U3.26 (PD6/D-/RXD1/MISO); also elsewhere on the board
/Control/SCL_ZEBROBUS: U12.7 (SCLB); also elsewhere on the board
/Control/SDA_ZEBROBUS: U12.6 (SDAB); also elsewhere on the board
/Control/TX: U3.27 (PD7/D+/TXD1/SCK/CLKOUT/EVOUT); also elsewhere on the board
/Control/bus_alert: U3.4 (AREFB/ADC8/PB0); also elsewhere on the board
/Control/pwm_solar: U3.13 (SCLOUT/TXD0/OC0BHS/OC0D/PC3); also elsewhere on the board
/Control/v_laptop: D3.1 (K), U3.44 (AC4/ADC4/PA4); also elsewhere on the board
/Input/INPUT_SEL: U3.6 (DAC0/ADC10/PB2); also elsewhere on the board
/QI_charging/EN_MCU_QI: U3.25 (PD5/OC1B/XCK1/MOSI); also elsewhere on the board
/QI_charging/INT_MCU_QI: U3.5 (ADC9/PB1); also elsewhere on the board
/QI_charging/SCL_MCU_QI: R6.2, U1.2 (SCL), U2.2 (SCL), U3.29 (PE1/OC0B/XCK0/SCL); also elsewhere on the board
/QI_charging/SDA_MCU_QI: R5.2, U1.1 (SDA), U2.1 (SDA), U3.28 (PE0/OC0A/SDA); also elsewhere on the board
GND: C1.2, C2.2, C3.2, C4.2, C5.2, C6.2, C7.1, C8.2, C9.2, C10.2, D1.1 (K), D3.2 (A), D4.2 (A), D5.2 (A), D6.2 (A), D12.1 (K), Q1.2, U1.4 (GND), U1.5 (A2), U1.6 (A1), U1.7 (A0), U2.4 (GND), U2.5 (A2), U2.6 (A1), U3.8 (GND), U3.18 (GND), U3.30 (GND), U3.38 (GND), U12.4 (GND); also elsewhere on the board
unnamed: C3.1, C4.1, C5.1, C6.1, D2.1 (K), L1.1, U3.9 (VCC), U3.19 (VCC), U3.31 (VCC)
unnamed: C7.2, C8.1, L1.2, U3.39 (AVCC)
unnamed: D1.2 (A), R2.2
unnamed: D12.2 (A), R47.2
unnamed: Q1.1, U3.17 (EVOUT/CLKOUT/SCK/TXD1/OC0DHS/PC7)
unnamed: R1.2, U2.7 (A0)
unnamed: R2.1, U3.36 (PR0/XTAL2/TOSC2)
unnamed: R3.2, U1.3 (OS), U3.33 (PE3/OC0D/TXD0)
unnamed: R4.2, U2.3 (OS), U3.32 (PE2/OC0C/RXD0)
unnamed: R8.2, U3.10 (SDAIN/SDA/~OC0ALS~/OC0A/PC0), U12.3 (SDAA)
unnamed: R9.2, U3.11 (SCLIN/SCL/XCK0/OC0AHS/OC0B/PC1), U12.2 (SCLA)
unnamed: R47.1, U3.37 (PR1/XTAL1/TOSC1)
unnamed: U3.12 (SDAOUT/RXD0/~OC0BLS~/OC0C/PC2), U12.5 (EN)

Notes on the sheet:
2 Temp sensors close to input/ouput converters
Analog input protection
ZebroBus buffer
Internal communication bus
Backup power for 0.25s
Debug LED

Schematic: input.sch

Parts:
C11: 0.1u; C_0603
C12, C15: 0.1u; C_0402
C13, C14, C16: 10u; C_0603
C17, C22, C23: 47u; CP_Tantalum_Case-X_EIA-7343-43_Hand
C18, C19: 4.7n; C_0402
C20, C21: 2.2u; C_1210
D8: PMEG100V060ELPDZ; TO-277A
D9: MBR360G; D_DO-201_P15.24mm_Horizontal
D21, D22: LED; LED_0603
F1, F5: FUSE; 0154001.DR
INA1: INA226; VSSOP-10_3x3mm_Pitch0.5mm
L2, L4: 680u; coil1115x1000
L3, L5: 680u; L_1210
Q2, Q3, Q5, Q6: IPD85P04P4-07; TO-252-3_TabPin2
Q4: BSS316N H6327; SOT-23
R11: 100k; R_0603
R12: 8k; R_0603
R13: 470k; R_0402
R14: 11k; R_0402
R15: 2k; R_0402
R16: 100m; R_0402
R17: 60k; R_0603
R51: 1.4k; R_0603_HandSoldering
R52: 500; R_0603_HandSoldering
U4: LTC4412; TSOT-23-6
U5: AD5121; LFCSP-16-1EP_3x3mm_Pitch0.5mm
U6: LT1370; LT1370CT7

Connections:
+3V3: C11.1, C12.1, C13.1, C14.1, INA1.6 (VS+), U5.7 (RESET), U5.8 (DIS), U5.9 (VDD), U5.10 (VLOGIC), U5.13 (WP), U5.16 (LRDAC); also elsewhere on the board
/Control/pwm_solar: Q4.1; also elsewhere on the board
/Control/v_laptop: R11.2, R12.1; also elsewhere on the board
/Input/INPUT_SEL: U4.3 (CTL); also elsewhere on the board
/Input/LAPTOP_IN+: Q3.2, R11.1, R51.1, U4.1 (Vin); also elsewhere on the board
/Input/LAPTOP_IN-: C17.2, C19.2, C23.1, D8.3, Q5.2, R15.2, U4.2 (GND), U5.2 (A), U5.3 (W), U6.4 (GND); also elsewhere on the board
/Input/POT_OUT: R14.1, R17.2, U6.6 (NFB)
/Input/QI_IN+: Q2.2, R52.1; also elsewhere on the board
/Input/solar_in+: F5.1; also elsewhere on the board
/Input/solar_in-: C22.1, D9.1 (K), Q4.2, Q6.2; also elsewhere on the board
/PowerBus/BMS_POWERBUS_-: C22.2, C23.2, L4.1, L5.1, Q5.1, Q6.1, R17.1; also elsewhere on the board
/PowerBus/INPUT_POWERBUS+: Q5.3, Q6.3; also elsewhere on the board
/QI_charging/SCL_MCU_QI: INA1.5 (SCL), U5.11 (SCLK/SCL); also elsewhere on the board
/QI_charging/SDA_MCU_QI: INA1.2 (A0), INA1.4 (SDA), U5.12 (SDI/SDA); also elsewhere on the board
GND: C11.2, C12.2, C13.2, C14.2, C15.2, C16.2, D21.1 (K), D22.1 (K), INA1.1 (A1), INA1.7 (GND), R12.2, U5.1 (GND), U5.6 (SYNC/ADDR0), U5.14 (SDO/ADDR1); also elsewhere on the board
unnamed: C15.1, C16.1, U5.5 (VSS)
unnamed: C17.1, F1.2, L2.2, U6.7 (Vin)
unnamed: C18.1, C19.1, U6.1 (Vc)
unnamed: C18.2, R15.1
unnamed: C20.1, L2.1, U6.5 (Vsw)
unnamed: C20.2, D8.2, L4.2
unnamed: C21.1, L3.1, Q4.3
unnamed: C21.2, D9.2 (A), L5.2
unnamed: D21.2 (A), R51.2
unnamed: D22.2 (A), R52.2
unnamed: F1.1, Q2.3, Q3.3, R13.1, U4.6 (SENSE)
unnamed: F5.2, INA1.8 (VBUS), INA1.10 (VIN+), R16.1
unnamed: INA1.9 (VIN-), L3.2, R16.2
unnamed: Q2.1, R13.2, U4.4 (STAT)
unnamed: Q3.1, U4.5 (GATE)
unnamed: R14.2, U5.4 (B)

Notes on the sheet:
Power path selector Able to switch between laptop and QI
Cuk converter for laptop or QI to 12.0-16.8V
Cuk converter for PV to 12.0-16.8V
Digital potentiometer

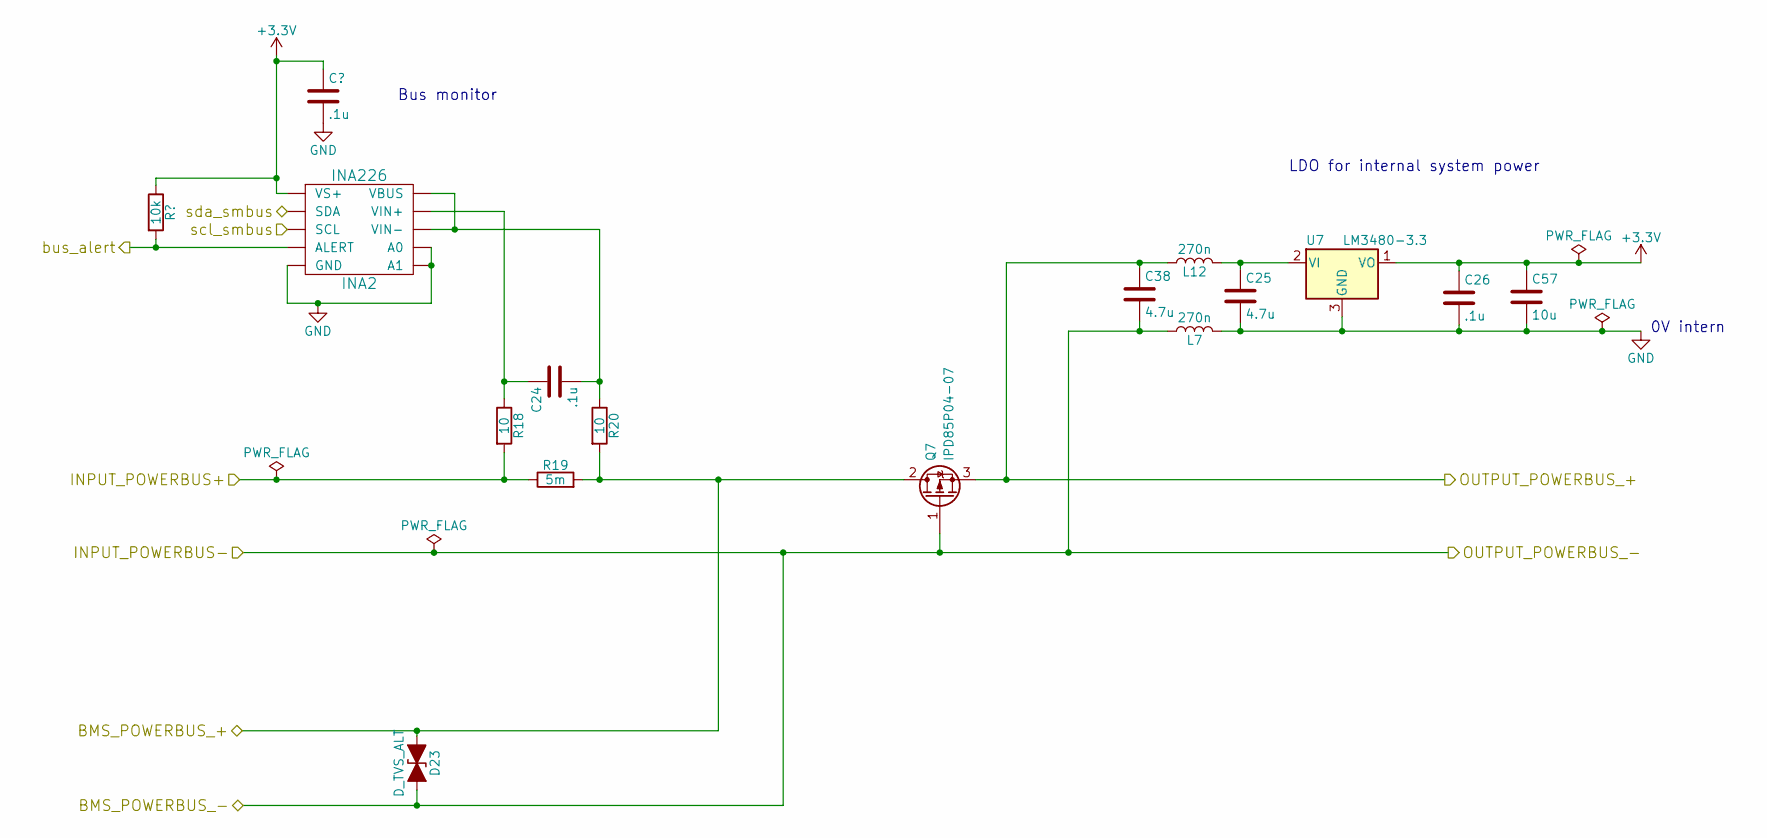
[picture p36: schematic powerbus.sch]

Parts:
C24, C26: .1u; C_0201
C25, C38: 4.7u; C_0805_HandSoldering
C57: 10u; C_0603_HandSoldering
D23: D_TVS_ALT; D_SOD-323
INA2: INA226; VSSOP-10_3x3mm_Pitch0.5mm
L7, L12: 270n; L_1210_HandSoldering
Q7: IPD85P04-07; TO-252-3_TabPin2
R18, R20: 10; R_0201
R19: 5m; R_2010
U7: LM3480-3.3; SOT-23

Connections:
+3V3: C26.1, C57.1, INA2.6 (VS+), U7.1 (VO); also elsewhere on the board
/Control/bus_alert: INA2.3 (ALERT); also elsewhere on the board
/PowerBus/BMS_POWERBUS_+: D23.1 (A1), Q7.2 (D), R19.2, R20.2; also elsewhere on the board
/PowerBus/BMS_POWERBUS_-: C38.2, D23.2 (A2), L7.1, Q7.1 (G); also elsewhere on the board
/PowerBus/INPUT_POWERBUS+: R18.2, R19.1; also elsewhere on the board
/PowerBus/OUTPUT_POWERBUS_+: C38.1, L12.1, Q7.3 (S); also elsewhere on the board
/QI_charging/SCL_MCU_QI: INA2.5 (SCL); also elsewhere on the board
/QI_charging/SDA_MCU_QI: INA2.4 (SDA); also elsewhere on the board
GND: C25.2, C26.2, C57.2, INA2.1 (A1), INA2.2 (A0), INA2.7 (GND), L7.2, U7.3 (GND); also elsewhere on the board
unnamed: C24.1, INA2.10 (VIN+), R18.1
unnamed: C24.2, INA2.8 (VBUS), INA2.9 (VIN-), R20.1
unnamed: C25.1, L12.2, U7.2 (VI)

Notes on the sheet:
LDO for internal system power
Bus monitor
0V intern

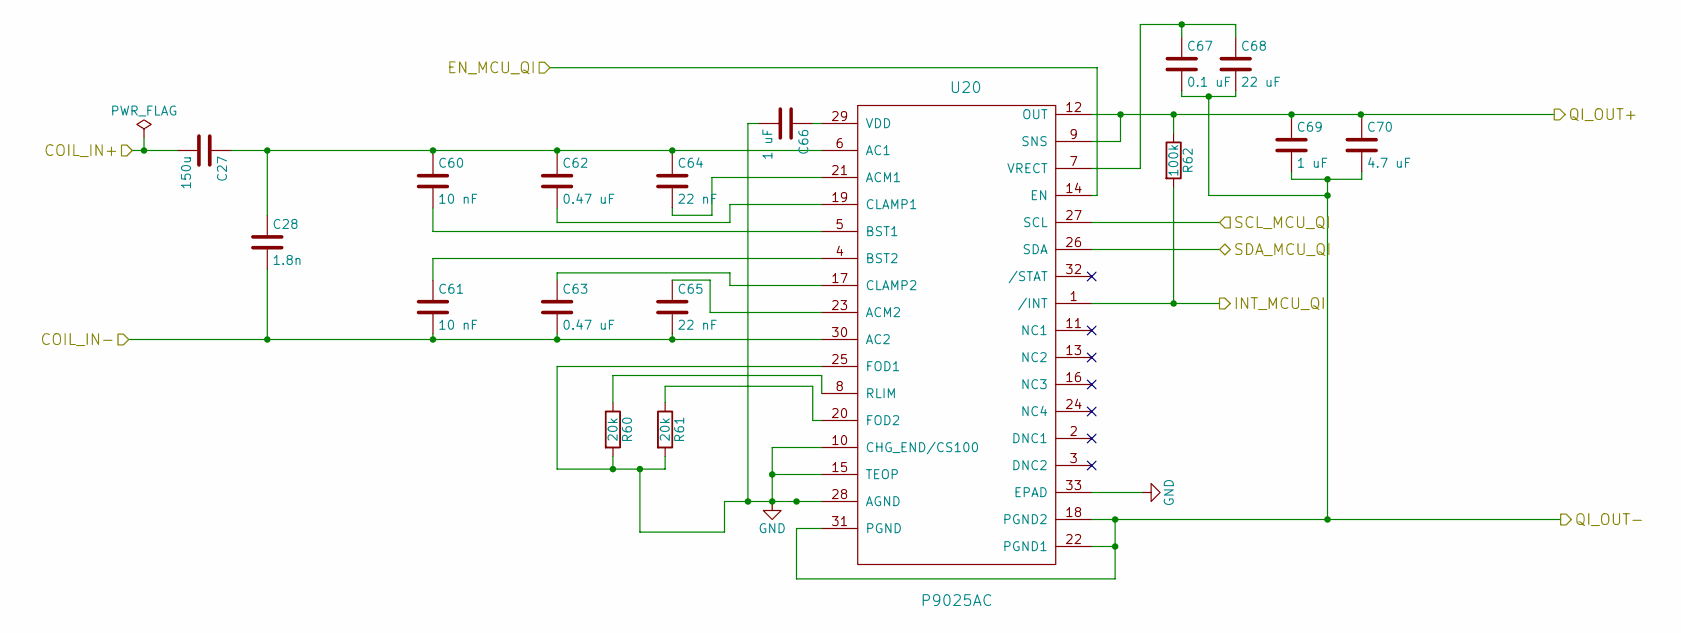
[picture p37: schematic QI_charging.sch]

Parts:
C27: 150u; CP_Radial_D8.0mm_P3.50mm
C28: 1.8n; C_0402
C60, C61: 10 nF; C_0402
C62, C63: 0.47 uF; C_0603
C64, C65: 22 nF; C_0402
C66, C69: 1 uF; C_0402
C67: 0.1 uF; C_0603
C68: 22 uF; C_0805
C70: 4.7 uF; C_0603
R60, R61: 20k; R_0603
R62: 100k; R_0603
U20: P9025AC; QFN-32-1EP_5x5mm_Pitch0.5mm

Connections:
/Input/LAPTOP_IN-: C67.2, C68.2, C69.2, C70.2, U20.18 (PGND2), U20.22 (PGND1), U20.31 (PGND); also elsewhere on the board
/Input/QI_IN+: C69.1, C70.1, R62.1, U20.9 (SNS), U20.12 (OUT); also elsewhere on the board
/QI_charging/COIL_IN+: C27.2; also elsewhere on the board
/QI_charging/COIL_IN-: C28.2, C61.2, C63.2, C65.2, U20.30 (AC2); also elsewhere on the board
/QI_charging/EN_MCU_QI: U20.14 (EN); also elsewhere on the board
/QI_charging/INT_MCU_QI: R62.2, U20.1 (/INT); also elsewhere on the board
/QI_charging/SCL_MCU_QI: U20.27 (SCL); also elsewhere on the board
/QI_charging/SDA_MCU_QI: U20.26 (SDA); also elsewhere on the board
GND: C66.2, R60.2, R61.2, U20.10 (CHG_END/CS100), U20.15 (TEOP), U20.25 (FOD1), U20.28 (AGND), U20.33 (EPAD); also elsewhere on the board
unnamed: C27.1, C28.1, C60.1, C62.1, C64.1, U20.6 (AC1)
unnamed: C60.2, U20.5 (BST1)
unnamed: C61.1, U20.4 (BST2)
unnamed: C62.2, U20.19 (CLAMP1)
unnamed: C63.1, U20.17 (CLAMP2)
unnamed: C64.2, U20.21 (ACM1)
unnamed: C65.1, U20.23 (ACM2)
unnamed: C66.1, U20.29 (VDD)
unnamed: C67.1, C68.1, U20.7 (VRECT)
unnamed: R60.1, U20.8 (RLIM)
unnamed: R61.1, U20.20 (FOD2)

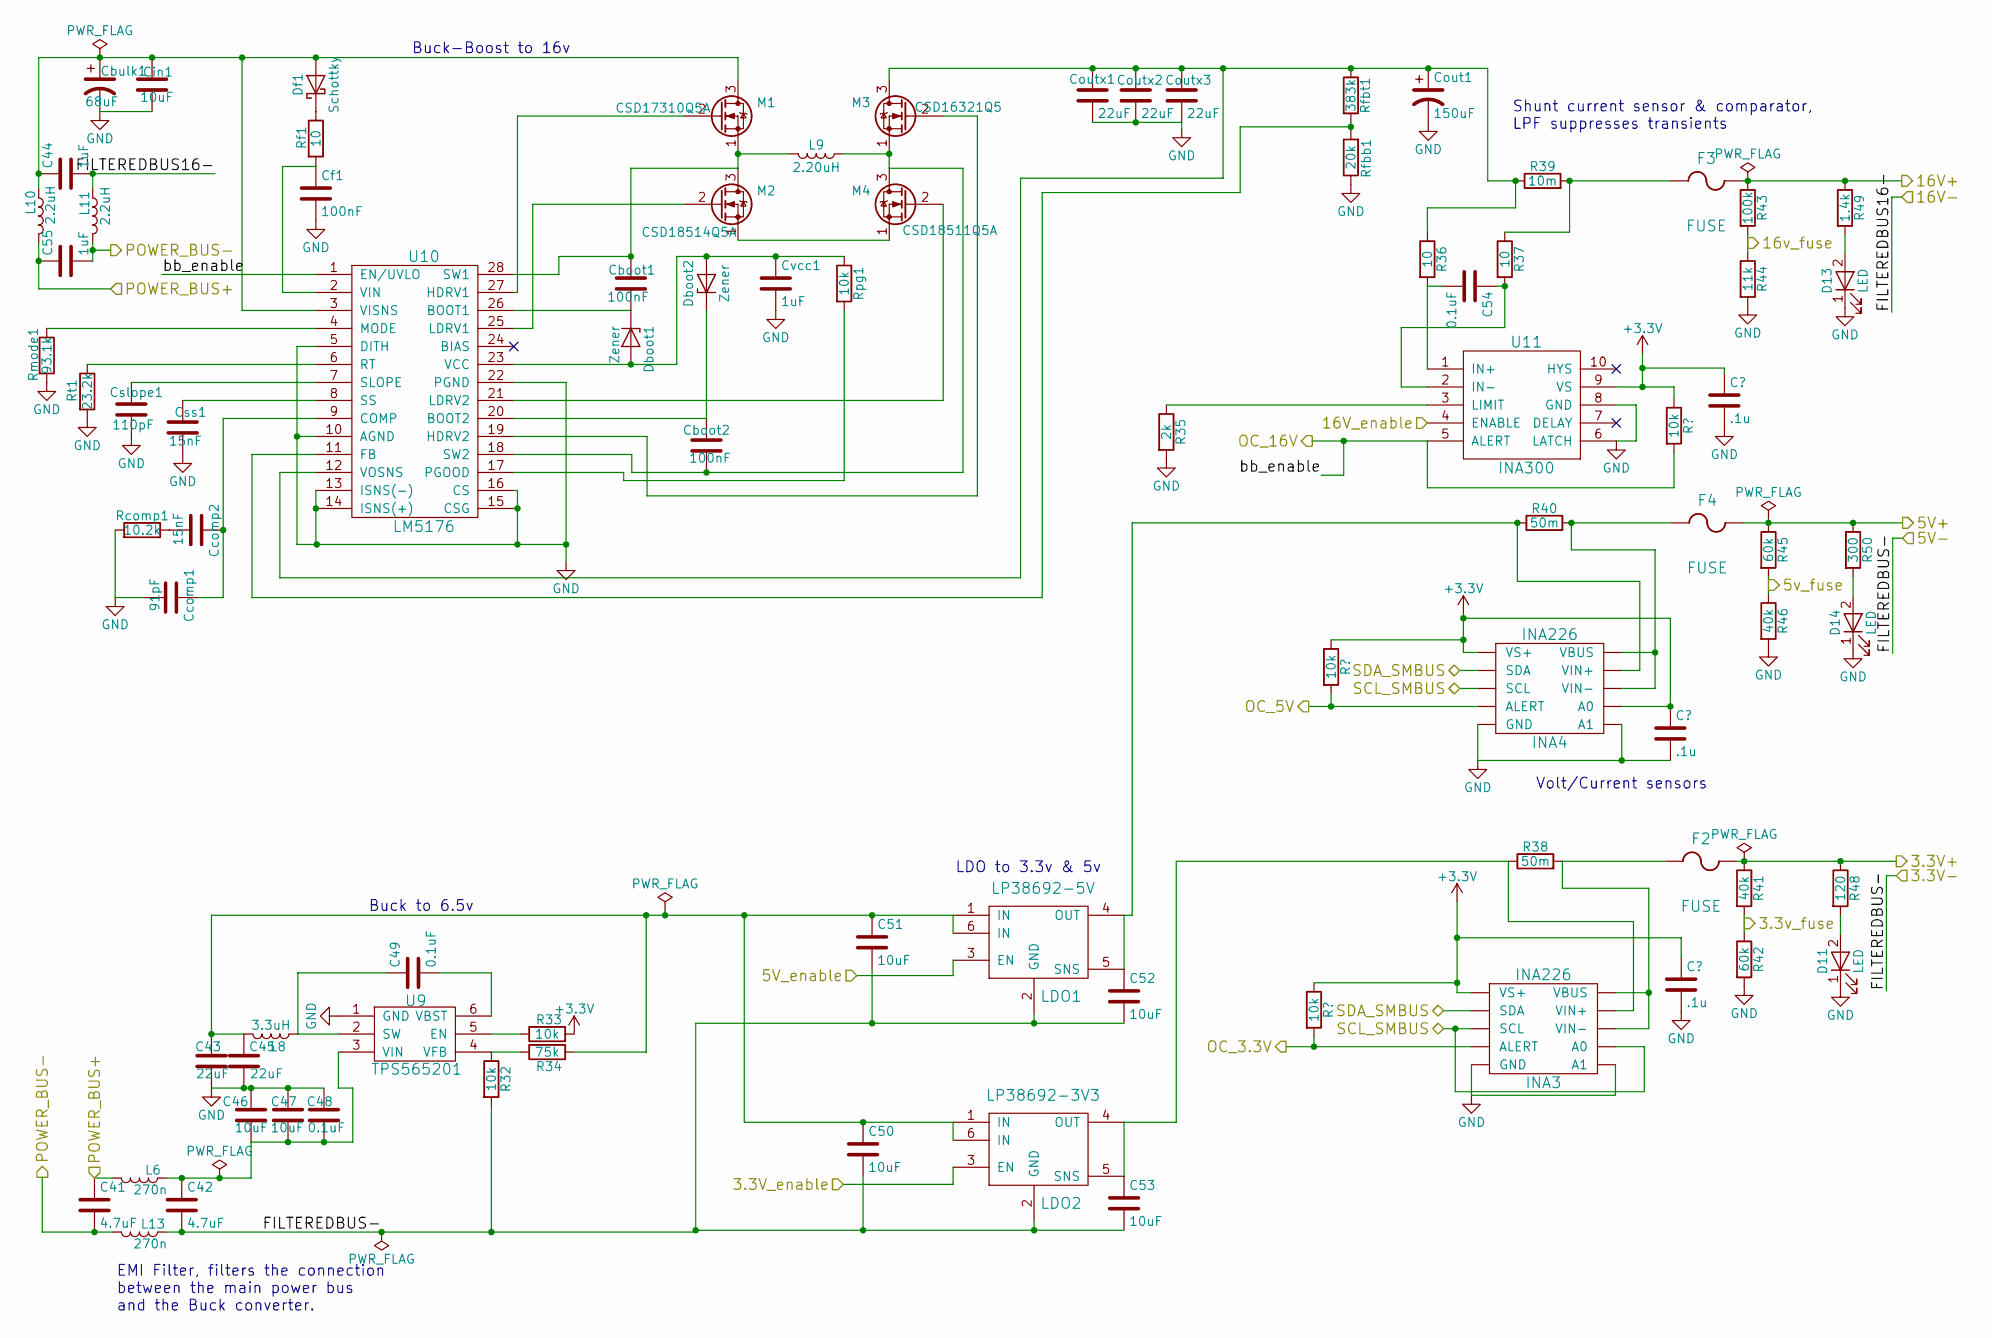
[picture p38: schematic output.sch]

Parts:
C41, C42: 4.7uF; C_0805_HandSoldering
C43, C45: 22uF; C_0805
C44, C55: 1uF; C_0603_HandSoldering
C46, C47, C50, C51, C52, C53: 10uF; C_0603
C48, C49: 0.1uF; C_0402
C54: 0.1uF; C_0201
Cboot1, Cboot2: 100nF; C_0603
Cbulk1: 68uF; CP_Elec_6.3x7.7
Ccomp1: 91pF; C_0805
Ccomp2: 15nF; C_0805
Cf1: 100nF; C_0603
Cin1: 10uF; C_1210
Cout1: 150uF; CP_Elec_10x10.5
Coutx1, Coutx2, Coutx3: 22uF; C_0805
Cslope1: 110pF; C_0603
Css1: 15nF; C_0603
Cvcc1: 1uF; C_0603
D11, D13, D14: LED; LED_0603
Dboot1: Zener; D_SOD-123F; Part number PMEG6010CEH
Dboot2: Zener; D_SOD-123F
Df1: Schottky; D_SOD-123F
F2, F4: FUSE; 0154001.DR
F3: FUSE; 0154005.DR
INA3, INA4: INA226; VSSOP-10_3x3mm_Pitch0.5mm
L6, L13: 270n; L_1210_HandSoldering
L8: 3.3uH; L_Wuerth_HCI-7040
L9: 2.20uH; L_Wuerth_HCI-7040
L10, L11: 2.2uH; L_Wuerth_HCI-7040
LDO1: LP38692-5V; WSON-6-1EP_3x3mm_Pitch0.95mm
LDO2: LP38692-3V3; WSON-6-1EP_3x3mm_Pitch0.95mm
M1: CSD17310Q5A; VSONP-8-1EP_5x6_Pitch1.27mm
M2: CSD18514Q5A; VSONP-8-1EP_5x6_Pitch1.27mm
M3: CSD16321Q5; VSONP-8-1EP_5x6_Pitch1.27mm
M4: CSD18511Q5A; VSONP-8-1EP_5x6_Pitch1.27mm
R32, R33: 10k; R_1206
R34: 75k; R_1206
R35: 2k; R_0603
R36, R37: 10; R_0201
R38, R40: 50m; R_0402
R39: 10m; R_2010
R41, R46: 40k; R_0603
R42, R45: 60k; R_0603
R43: 100k; R_0603
R44: 11k; R_0603
R48: 120; R_0603
R49: 1.4k; R_0603
R50: 300; R_0603
Rcomp1: 10.2k; R_0402
Rf1: 10; R_0603
Rfbb1: 20k; R_0603
Rfbt1: 383k; R_0603
Rmode1: 93.1k; R_0603
Rpg1: 10k; R_0603
Rt1: 23.2k; R_0402
U9: TPS565201; SOT-23-6
U10: LM5176; HTSSOP-28_4.4x9.7mm_Pitch0.65mm_ThermalPad
U11: INA300; VSSOP-10_3x3mm_Pitch0.5mm

Connections:
+3V3: INA3.6 (VS+), INA4.2 (A0), INA4.6 (VS+), R33.2, U11.9 (VS); also elsewhere on the board
/Control/3.3V_enable: LDO2.3 (EN); also elsewhere on the board
/Control/3.3V_fuse: R41.2, R42.1; also elsewhere on the board
/Control/5V_enable: LDO1.3 (EN); also elsewhere on the board
/Control/5V_fuse: R45.2, R46.1; also elsewhere on the board
/Control/16V_enable: U11.4 (ENABLE); also elsewhere on the board
/Control/16V_fuse: R43.2, R44.1; also elsewhere on the board
/Control/OC_3.3V: INA3.3 (ALERT); also elsewhere on the board
/Control/OC_5V: INA4.3 (ALERT); also elsewhere on the board
/Control/OC_16V: U10.1 (EN/UVLO), U11.5 (ALERT); also elsewhere on the board
/Output/3.3V+: F2.2, R41.1, R48.1; also elsewhere on the board
/Output/3.3V-: C42.2, C50.2, C51.2, C52.2, C53.2, L13.1, LDO1.2 (GND), LDO2.2 (GND), R32.2; also elsewhere on the board
/Output/5V+: F4.2, R45.1, R50.1; also elsewhere on the board
/Output/16V+: F3.2, R43.1, R49.1; also elsewhere on the board
/Output/16V-: C44.2, L11.1; also elsewhere on the board
/Output/POWER_BUS+: C41.1, C55.1, L6.2, L10.2; also elsewhere on the board
/Output/POWER_BUS-: C41.2, C55.2, L11.2, L13.2; also elsewhere on the board
/QI_charging/SCL_MCU_QI: INA3.2 (A0), INA3.5 (SCL), INA4.5 (SCL); also elsewhere on the board
/QI_charging/SDA_MCU_QI: INA3.4 (SDA), INA4.4 (SDA); also elsewhere on the board
GND: C43.2, C45.2, C46.1, C47.1, C48.1, Cbulk1.2, Ccomp1.2, Cf1.2, Cin1.2, Cout1.2, Coutx1.2, Coutx2.2, Coutx3.2, Cslope1.2, Css1.2, Cvcc1.2, D11.1 (K), D13.1 (K), D14.1 (K), INA3.1 (A1), INA3.7 (GND), INA4.1 (A1), INA4.7 (GND), R35.2, R42.2, R44.2, R46.2, Rcomp1.2, Rfbb1.1, Rmode1.2, Rt1.2, U9.1 (GND), U10.5 (DITH), U10.10 (AGND), U10.13 (ISNS(-)), U10.14 (ISNS(+)), U10.15 (CSG), U10.16 (CS), U10.22 (PGND), U11.6 (LATCH), U11.8 (GND); also elsewhere on the board
unnamed: C42.1, C46.2, C47.2, C48.2, L6.1, U9.3 (VIN)
unnamed: C43.1, C45.1, C50.1, C51.1, L8.2, LDO1.1 (IN), LDO1.6 (IN), LDO2.1 (IN), LDO2.6 (IN), R34.2
unnamed: C44.1, Cbulk1.1, Cin1.1, Df1.2 (A), L10.1, M1.3 (D), U10.3 (VISNS)
unnamed: C49.1, L8.1, U9.2 (SW)
unnamed: C49.2, U9.6 (VBST)
unnamed: C52.1, INA4.10 (VIN+), LDO1.4 (OUT), LDO1.5 (SNS), R40.1
unnamed: C53.1, INA3.10 (VIN+), LDO2.4 (OUT), LDO2.5 (SNS), R38.1
unnamed: C54.1, R37.2, U11.2 (IN-)
unnamed: C54.2, R36.2, U11.1 (IN+)
unnamed: Cboot1.1, L9.2, M1.1 (S), M2.3 (D), U10.28 (SW1)
unnamed: Cboot1.2, Dboot1.1 (K), U10.26 (BOOT1)
unnamed: Cboot2.1, Dboot2.1 (K), U10.20 (BOOT2)
unnamed: Cboot2.2, L9.1, M3.1 (S), M4.3 (D), U10.18 (SW2)
unnamed: Ccomp1.1, Ccomp2.1, U10.9 (COMP)
unnamed: Ccomp2.2, Rcomp1.1
unnamed: Cf1.1, Rf1.2, U10.2 (VIN)
unnamed: Cout1.1, Coutx1.1, Coutx2.1, Coutx3.1, M3.3 (D), R36.1, R39.1, Rfbt1.1, U10.12 (VOSNS)
unnamed: Cslope1.1, U10.7 (SLOPE)
unnamed: Css1.1, U10.8 (SS)
unnamed: Cvcc1.1, Dboot1.2 (A), Dboot2.2 (A), Rpg1.1, U10.23 (VCC)
unnamed: D11.2 (A), R48.2
unnamed: D13.2 (A), R49.2
unnamed: D14.2 (A), R50.2
unnamed: Df1.1 (K), Rf1.1
unnamed: F2.1, INA3.8 (VBUS), INA3.9 (VIN-), R38.2
unnamed: F3.1, R37.1, R39.2
unnamed: F4.1, INA4.8 (VBUS), INA4.9 (VIN-), R40.2
unnamed: M1.2 (G), U10.27 (HDRV1)
unnamed: M2.1 (S), M4.1 (S)
unnamed: M2.2 (G), U10.25 (LDRV1)
unnamed: M3.2 (G), U10.19 (HDRV2)
unnamed: M4.2 (G), U10.21 (LDRV2)
unnamed: R32.1, R34.1, U9.4 (VFB)
unnamed: R33.1, U9.5 (EN)
unnamed: R35.1, U11.3 (LIMIT)
unnamed: Rfbb1.2, Rfbt1.2, U10.11 (FB)
unnamed: Rmode1.1, U10.4 (MODE)
unnamed: Rpg1.2, U10.17 (PGOOD)
unnamed: Rt1.1, U10.6 (RT)

Notes on the sheet:
Shunt current sensor & comparator, LPF suppresses transients
Buck to 6.5v
Buck-Boost to 16v
LDO to 3.3v & 5v
Volt/Current sensors
EMI Filter, filters the connection between the main power bus and the Buck converter.

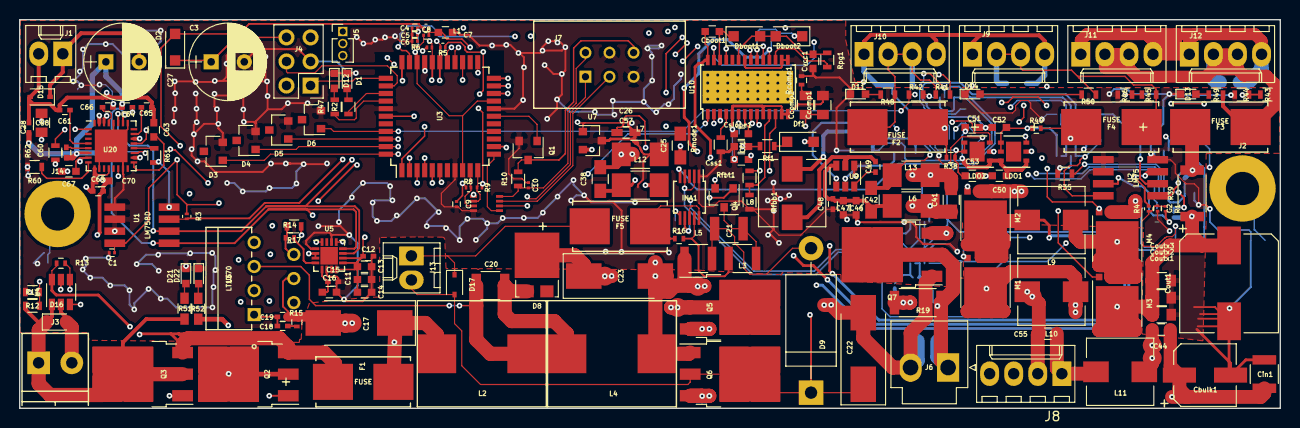
[picture p39: board main.kicad_pcb from above]

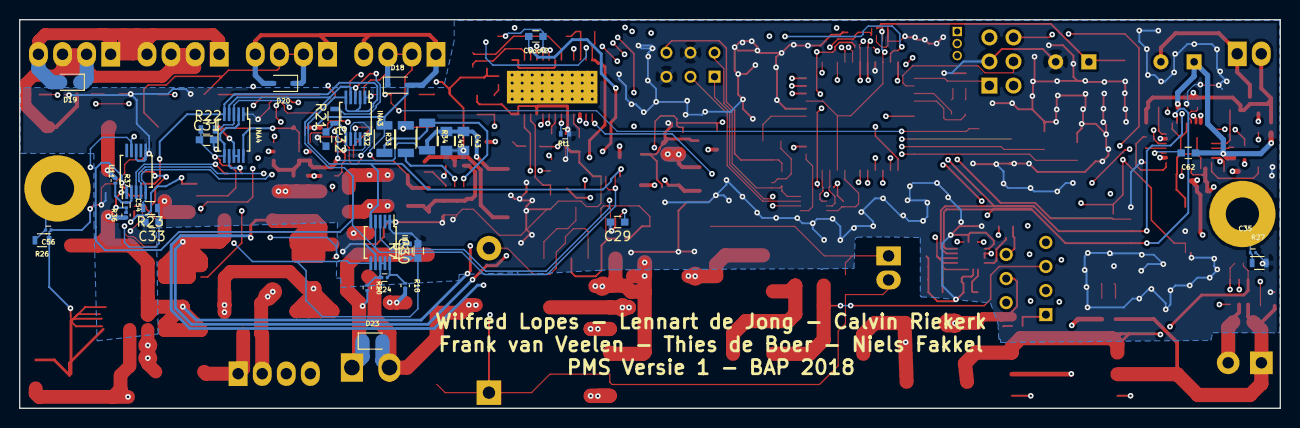
[picture p40: board main.kicad_pcb from below]

Board: 4 copper layers, 133.0 x 41.0 mm, 218 parts (35 on the bottom side), 131 nets.

Other parts of the board:
C29, C30, C31, C32, C33: .1u; C_0603
R7, R21, R22, R23: 10k; R_0603

Their connections:
+3V3: C29.1, C30.1, C31.1, C32.1, C33.1, R7.1, R21.1, R22.1, R23.1; also elsewhere on the board
/Control/OC_3.3V: R21.2; also elsewhere on the board
/Control/OC_5V: R22.2; also elsewhere on the board
/Control/OC_16V: R23.2; also elsewhere on the board
/Control/bus_alert: R7.2; also elsewhere on the board
GND: C29.2, C30.2, C31.2, C32.2, C33.2; also elsewhere on the board
