nfakkel/DeciZebroPowerSystemControl/Schematics/BMS_final/BMS_final.kicad_pcb

## KiCad design Schematics/BMS_final/BMS_final.kicad_pcb (2018-06-18)

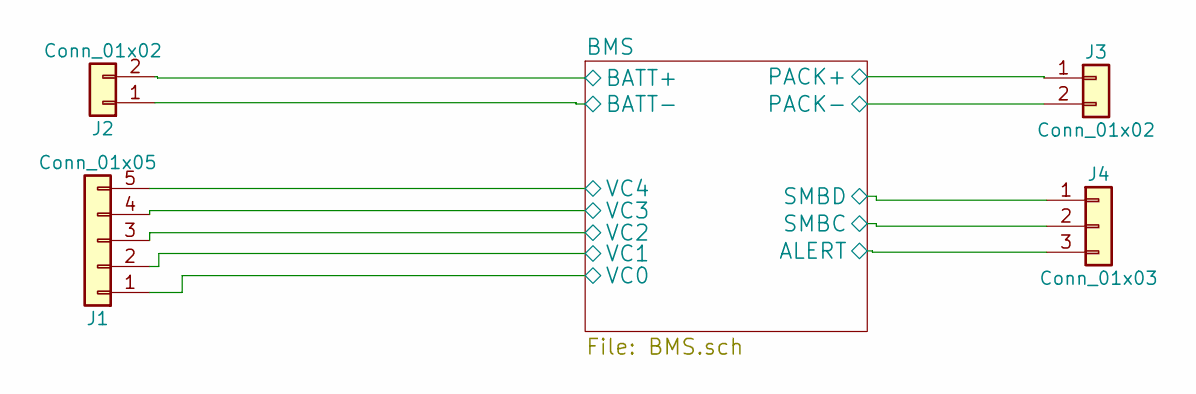
[picture p41: schematic BMS_final.sch]

Parts:
J1: Conn_01x05; JST_XH_B05B-XH-A_05x2.50mm_Straight
J2, J3: Conn_01x02; JST_VH_B2P-VH-FB-B_2x3.96mm_Vertical
J4: Conn_01x03; Pin_Header_Straight_1x03_Pitch2.54mm

Connections:
/BMS/ALERT: J4.3; also elsewhere on the board
/BMS/BATT+: J1.5, J2.2; also elsewhere on the board
/BMS/BATT-: J1.1, J2.1; also elsewhere on the board
/BMS/PACK+: J3.1; also elsewhere on the board
/BMS/PACK-: J3.2; also elsewhere on the board
/BMS/SMBC: J4.2; also elsewhere on the board
/BMS/SMBD: J4.1; also elsewhere on the board
/BMS/VC1: J1.2; also elsewhere on the board
/BMS/VC2: J1.3; also elsewhere on the board
/BMS/VC3: J1.4; also elsewhere on the board
