nfakkel/DeciZebroPowerSystemControl/Schematics/BMS_final/BMS_final.kicad_pcb

## KiCad design Schematics/BMS_final/BMS_final.kicad_pcb (continued)

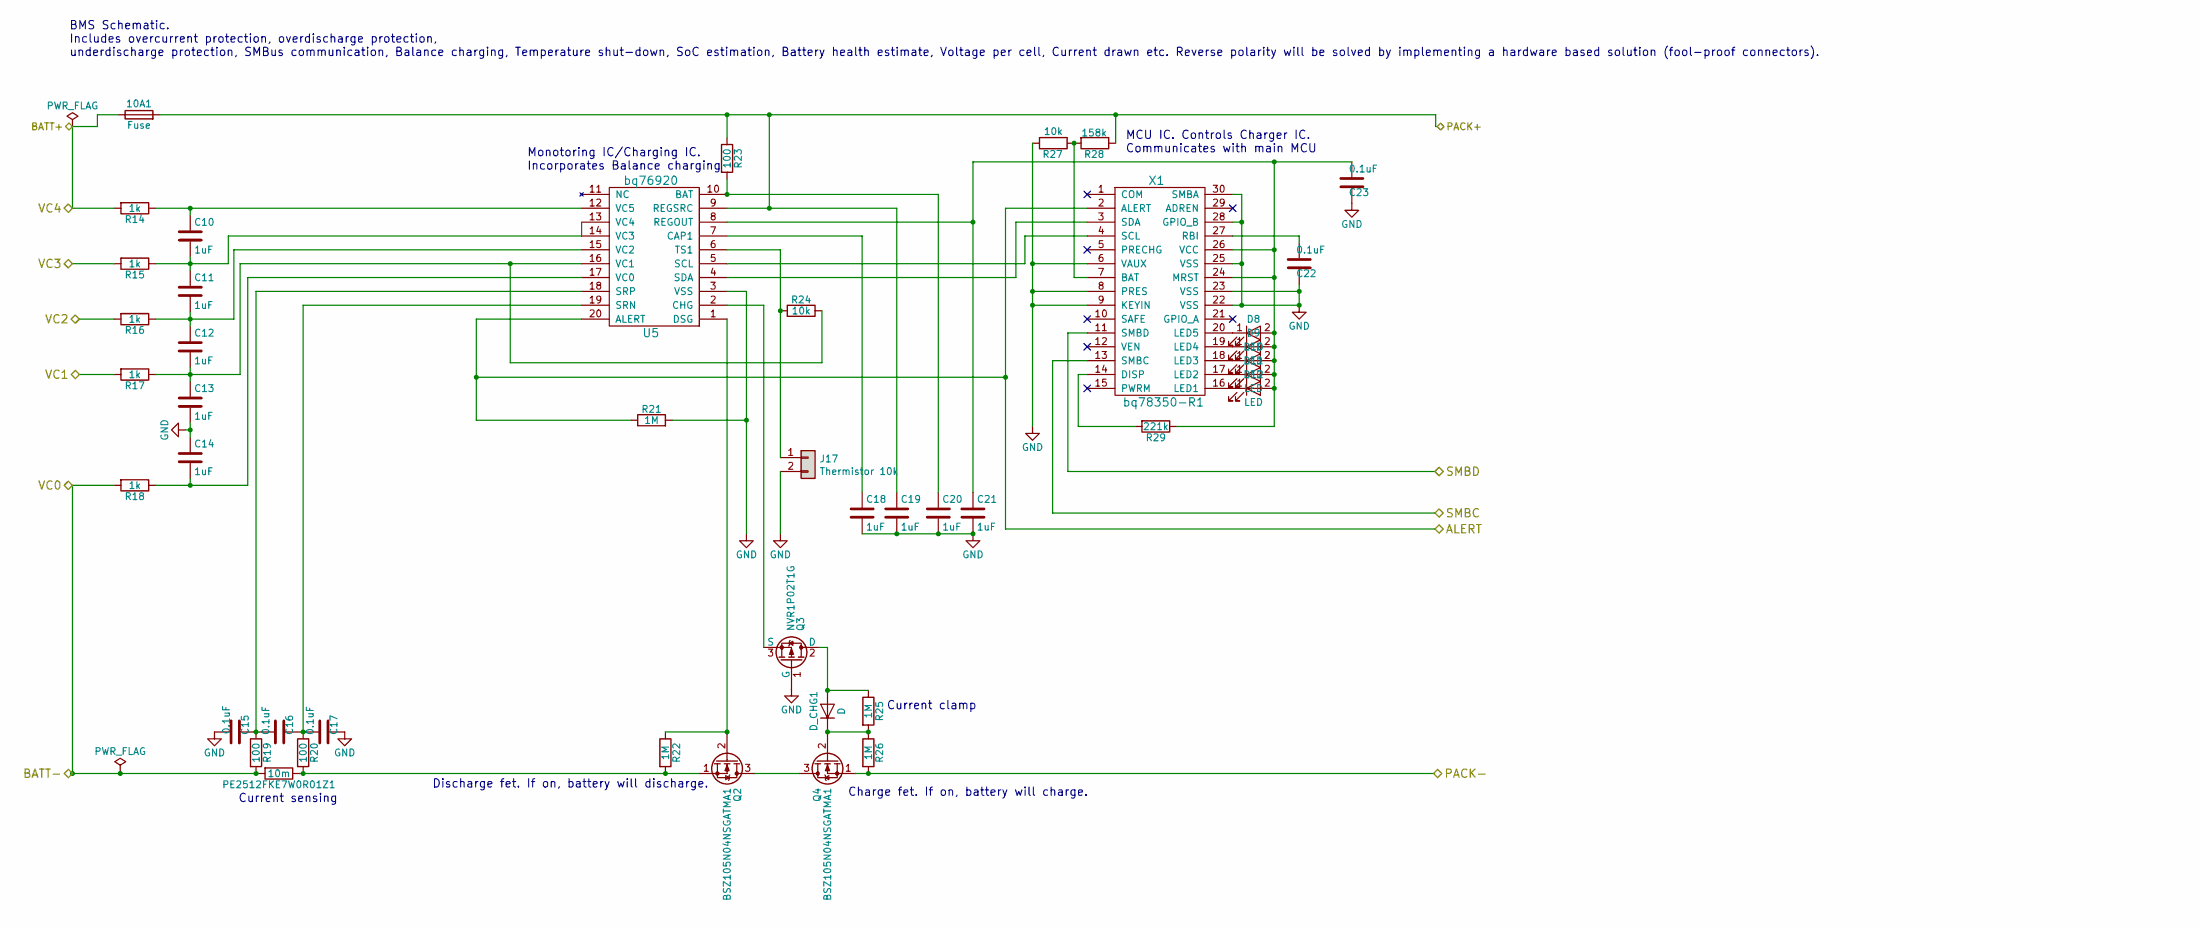
[picture p42: schematic BMS.sch]

Parts:
10A1: Fuse
C10, C11, C12, C13, C14, C18, C19, C20, C21: 1uF; C_0603
C15, C16, C17, C22, C23: 0.1uF; C_0402
D8, D9, D10, D11, D12: LED; LED_0603
D_CHG1: D; D_SOD-323
J17: Thermistor 10k; PINHEAD1-2
PE2512FKE7W0R01Z1: 10m; R_2512
Q2, Q4: BSZ105N04NSGATMA1; TO-263-2
Q3: NVR1P02T1G; SOT-23
R14, R15, R16, R17, R18: 1k; R_0402
R19, R20, R23: 100; R_0402
R21, R22, R25, R26: 1M; R_0603
R24, R27: 10k; R_0603
R28: 158k; R_0603
R29: 221k; R_0603
U5: bq76920; TSSOP-20_4.4x6.5mm_Pitch0.65mm
X1: bq78350-R1; TSSOP-30_4.4x7.8mm_P0.5mm

Connections:
/BMS/ALERT: R21.1, U5.20 (ALERT), X1.2 (ALERT); also elsewhere on the board
/BMS/BATT+: 10A1.1, R14.2; also elsewhere on the board
/BMS/BATT-: PE2512FKE7W0R01Z1.2, R18.2, R19.2; also elsewhere on the board
/BMS/PACK+: 10A1.2, C19.1, R23.1, R28.1, U5.9 (REGSRC); also elsewhere on the board
/BMS/PACK-: Q4.1 (S), R26.2; also elsewhere on the board
/BMS/SMBC: X1.13 (SMBC); also elsewhere on the board
/BMS/SMBD: X1.11 (SMBD); also elsewhere on the board
/BMS/VC1: R17.2; also elsewhere on the board
/BMS/VC2: R16.2; also elsewhere on the board
/BMS/VC3: R15.2; also elsewhere on the board
GND: C13.2, C14.1, C15.2, C17.1, C18.2, C19.2, C20.2, C21.2, C22.1, C23.1, J17.2, Q3.1 (G), R21.2, R27.2, U5.3 (VSS), X1.6 (VAUX), X1.8 (PRES), X1.9 (KEYIN), X1.22 (VSS), X1.23 (VSS), X1.25 (VSS), X1.28 (GPIO_B), X1.30 (SMBA)
unnamed: C10.1, R14.1, U5.12 (VC5)
unnamed: C10.2, C11.1, R15.1, U5.13 (VC4), U5.14 (VC3)
unnamed: C11.2, C12.1, R16.1, U5.15 (VC2)
unnamed: C12.2, C13.1, R17.1, R24.1, U5.16 (VC1)
unnamed: C14.2, R18.1, U5.17 (VC0)
unnamed: C15.1, C16.2, R19.1, U5.18 (SRP)
unnamed: C16.1, C17.2, R20.1, U5.19 (SRN)
unnamed: C18.1, U5.7 (CAP1)
unnamed: C20.1, R23.2, U5.10 (BAT)
unnamed: C21.1, C23.2, D8.2 (A), D9.2 (A), D10.2 (A), D11.2 (A), D12.2 (A), R29.1, U5.8 (REGOUT), X1.24 (MRST), X1.26 (VCC)
unnamed: C22.2, X1.27 (RBI)
unnamed: D8.1 (K), X1.20 (LED5)
unnamed: D9.1 (K), X1.19 (LED4)
unnamed: D10.1 (K), X1.18 (LED3)
unnamed: D11.1 (K), X1.17 (LED2)
unnamed: D12.1 (K), X1.16 (LED1)
unnamed: D_CHG1.1 (K), Q4.2 (G), R25.2, R26.1
unnamed: D_CHG1.2 (A), Q3.2 (D), R25.1
unnamed: J17.1, R24.2, U5.6 (TS1)
unnamed: PE2512FKE7W0R01Z1.1, Q2.1 (S), R20.2, R22.2
unnamed: Q2.2 (G), R22.1, U5.1 (DSG)
unnamed: Q2.3 (D), Q4.3 (D)
unnamed: Q3.3 (S), U5.2 (CHG)
unnamed: R27.1, R28.2, X1.7 (BAT)
unnamed: R29.2, X1.14 (DISP)
unnamed: U5.4 (SDA), X1.3 (SDA)
unnamed: U5.5 (SCL), X1.4 (SCL)

Notes on the sheet:
Charge fet. If on, battery will charge.
Discharge fet. If on, battery will discharge.
Current clamp
Current sensing
Monotoring IC/Charging IC. Incorporates Balance charging
MCU IC. Controls Charger IC. Communicates with main MCU
BMS Schematic. Includes overcurrent protection, overdischarge protection, underdischarge protection, SMBus communication, Balance charging, Temperature shut-down, SoC estimation, Battery health estimate, Voltage per cell, Current drawn etc. Reverse polarity will be solved by implementing a hardware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

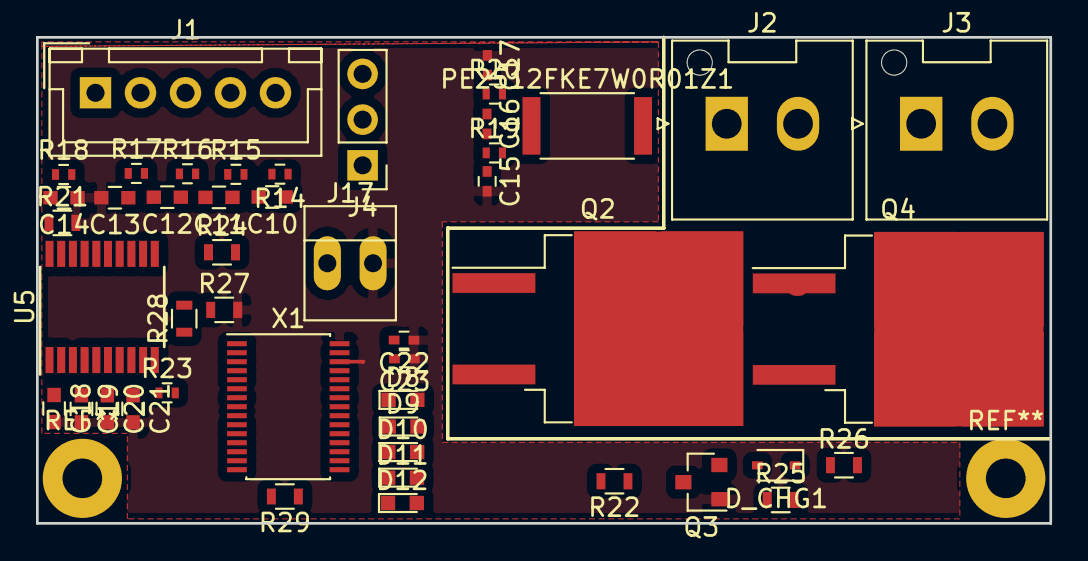
[picture p43: board BMS_final.kicad_pcb from above]

Board: 4 copper layers, 56.3 x 27.0 mm, 47 parts (0 on the bottom side), 38 nets.
